degugj/lichessTesting/html/images/SPECS1.png

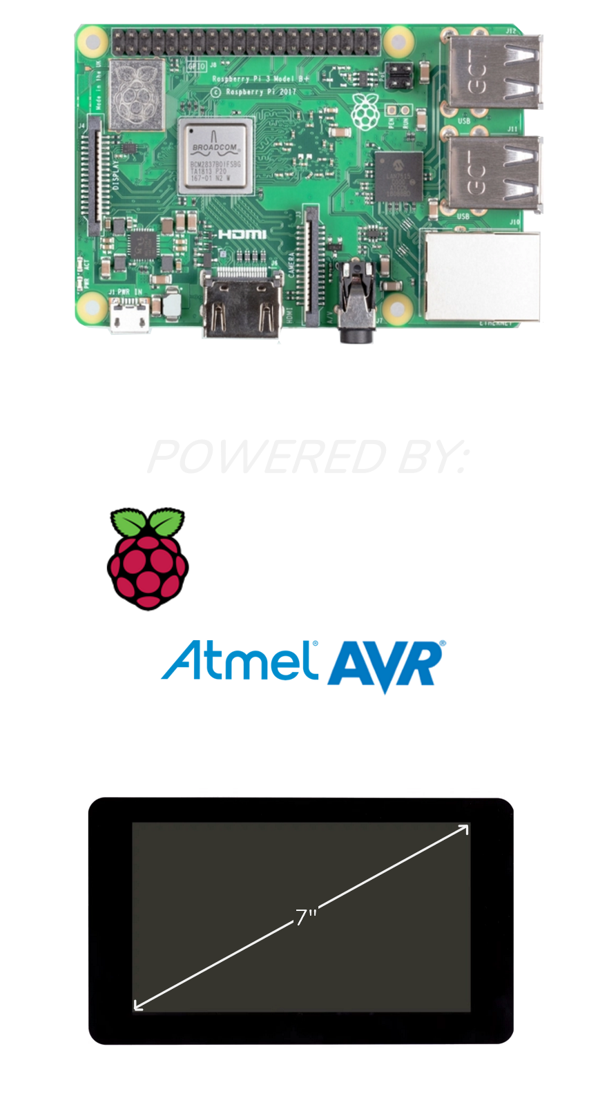
html/images/SPECS1.png
