degugj/lichessTesting/html/images/ZoomPortrait.png

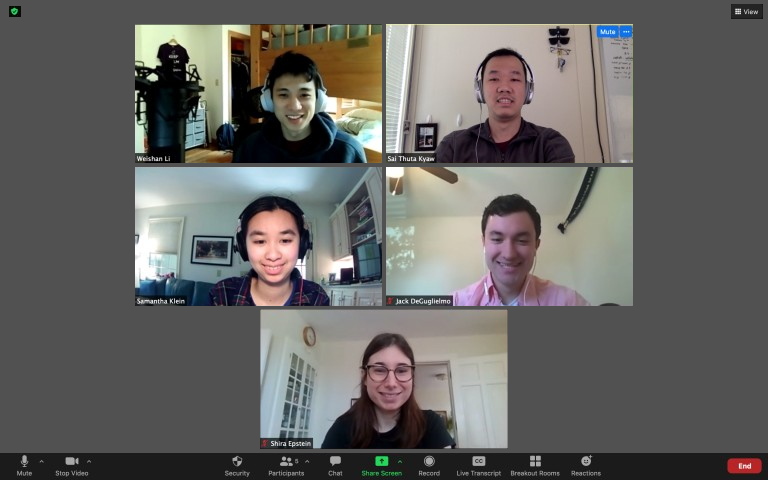
html/images/ZoomPortrait.png
