degugj/lichessTesting/readme.md

Magichess
============
Magichess is an autonomous, internet connected smart chessboard that interfaces with the the [lichess API](https://lichess.org/api).

**Contributors:**
  * Weishan Li CompE '21
  * Sai Thuta Kyaw EE '21
  * Samantha Klein EE '21
  * Jack DeGuglielmo CompE '21

University of Massachusetts Amherst '21
Electrical and Computer Engineering Senior Design Project
Team 10

## Dependencies

<!-- AUTO-GENERATED-CONTENT:START (DEPENDENCYTABLE) -->
| **Dependency** | **Description** | **Version** | **License** | **Type** |
| --- | --- | --- | --- | --- |
 | [pygame](https://github.com/pygame/pygame) | Open source software for illustrating game state. | 1.9.6 | GNU LGPL version 2.1 | N/A | 
 | [numpy](https://github.com/numpy/numpy) | N/A | N/A | N/A | N/A | 
 | [tkinter](https://github.com/python/cpython/tree/3.9/Lib/tkinter) | N/A | N/A | GPL | N/A | 
 | [Python](https://github.com/python/) | N/A | 3.8.8 | GPL | N/A | 
<!-- AUTO-GENERATED-CONTENT:END -->
