degugj/lichessTesting/html/pdf/T10 FPR.pdf

# MagiChess

## Jack DeGuglielmo, Samantha Klein, Weishan Li, Sai Thuta Kyaw

## Advisor: Shira Epstein

## Team 10

# Meet the team

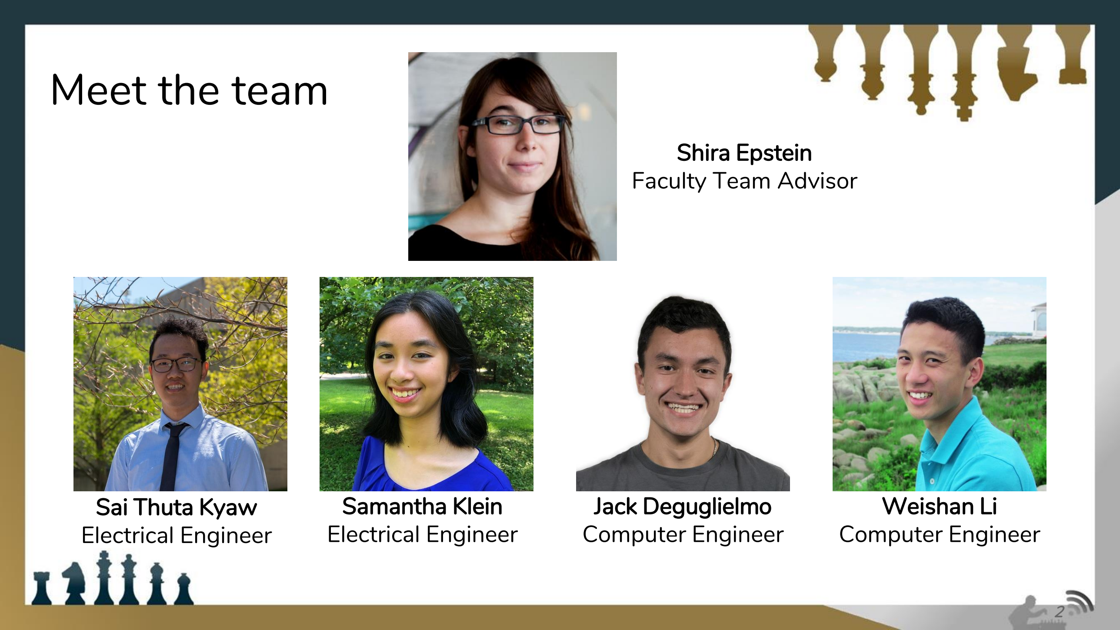
[picture p12: page 2]

Jack Deguglielmo
Computer Engineer

Samantha Klein
Electrical Engineer

Sai Thuta Kyaw
Electrical Engineer

Weishan Li
Computer Engineer

Shira Epstein
Faculty Team Advisor

# Problem Statement

For centuries, the game of chess has been played by two players sitting across a chessboard. The advent of digital technology in the last decades has brought virtual chess to computers and mobile phones and for the first time, this has allowed players to be anywhere across the world.

Digital chess lacks:
- A physical aspect/satisfaction of seeing and moving your own pieces Physical chess lacks:
- Ability to play from anywhere and with anyone

# Our Solution

We’ve decided to close the gap between physical and digital chess. To do this, we plan to create a chess board that allows users to play with an AI or a remote human opponent. Plan:
- Sense location of chess pieces on the board
- Interface with LiChess server
- Automate piece moving

# Preliminary System Specifications (Design-agnostic)

- Mechanically move a piece to destination cell
- Remove/replace a piece to/from game board
- Provide visual feedback
- Game setup, tutorial
- Game announcements
- Highlights previous move
- Provide audio feedback
- Notification alerts
- Play versus remote opponent
- Playback previous games
- Includes buffer zone to store captured pieces
- Topple the King after checkmate

# Preliminary System Specifications (Quantitative)

- Total system dimensions: no larger than 32.5 in x 30 in x 8in (80 cm x 74 cm x 15 cm )
- Speed of XY plotter: 5 - 8 cm/s
- Speed increased due to better stepper drivers
- Absolute maximum time taken for a move 25s
- Move each pieces under 10s more than half of the time
- Weight: Under 50lbs
- Upgrading from wood to more robust aluminium frame

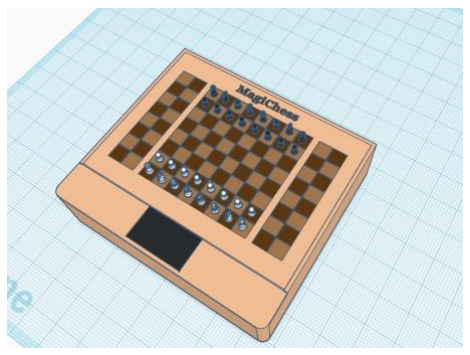
[picture p13: figure]

# Demo for Final System

- Tour the final assembly and hardware
- Comprehensive Gameplay Demo
- GUI Tour
- Functionalities to be covered:
■ | Capture (Movement and Sensor)
■ | Physical Gantry Movements
■ | Sensor Input Movements
- Game Replay Demo
- Previous Game Replay
- Topple King

# Documentation Overview

### - Communication Protocol Documents

- Fast Scanning Communication Protocol

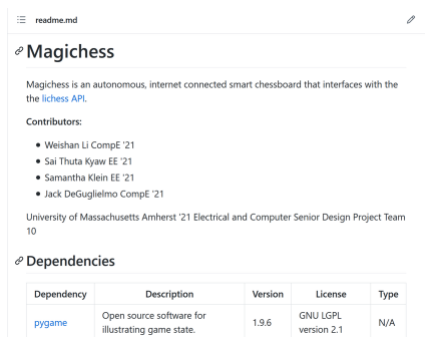
[picture p14: figure]
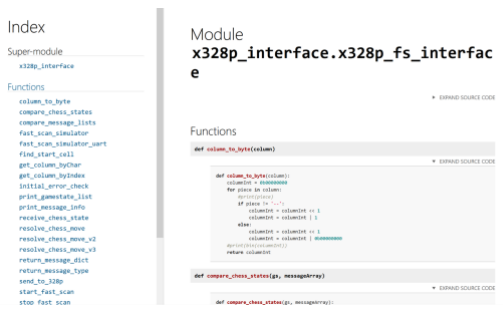
[picture p15: figure]

- XY Gantry Communication Protocol

### - System Software Documentation

- x328p_fs_interface.py (http://www.ecs.umass.edu/sdp/sdp21/team10/x328p_interface_docs/x328p_fs_interface.html) Document
- x328p_gantry_interface.py (http://www.ecs.umass.edu/sdp/sdp21/team10/x328p_interface_docs/x328p_gantry_interface.html) Document
- readme.md (https://github.com/degugj/lichessTesting/blob/master/readme.md) System Software Description

### - SDP Final Report

# Hardware + Software Flowchart

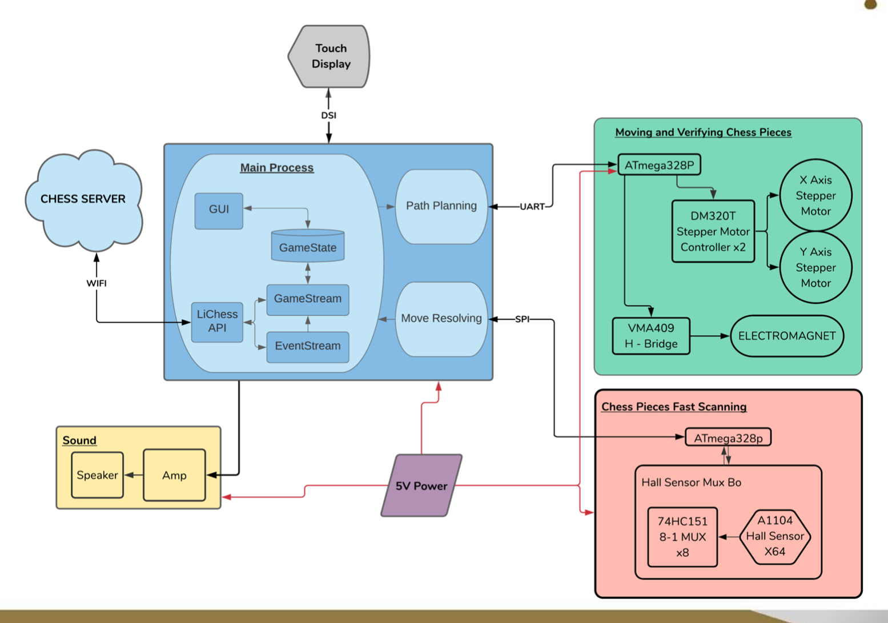
[picture p16: figure]

# Software Diagram - Game State

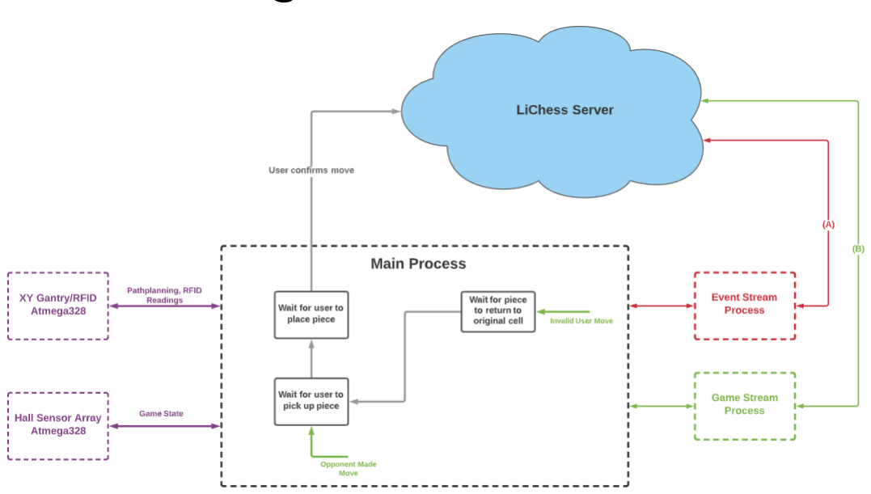
[picture p17: figure]

(A) gameStart,
challengeDeclined, …
(A) gameState, chatLine, ...

# Final System: GUI, Gamestate, Display

### - Graphical User Interface

- Interaction between chessboard, Lichess server, and user
- Housed on a Raspberry Pi touchscreen display
- Feedback provided through audio and various visual effects

### - Software Gamestate

- All moves (server-side and local-side) compare with and update our software gamestate
- Keeps track of physical pieces
- Stays aligned with server side gamestate
- Always on display to the user

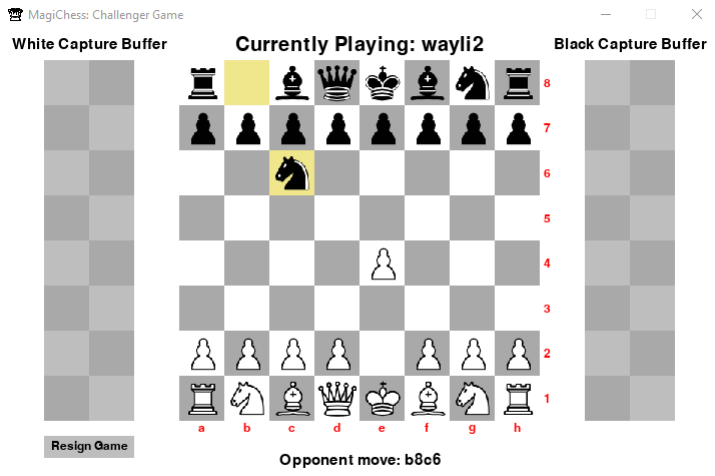
[picture p18: figure]

# Final System: Lichess Communication

### - Lichess

- Open source chess server with very well documented API
- Request and response communication

### - Gamestream and Eventstream

- Separate processes running simultaneously with main application
- Constantly request data from Lichess
- Place responses in respective queues and grab from main process

# Final System: Path Planning

### Path Planning Sequence

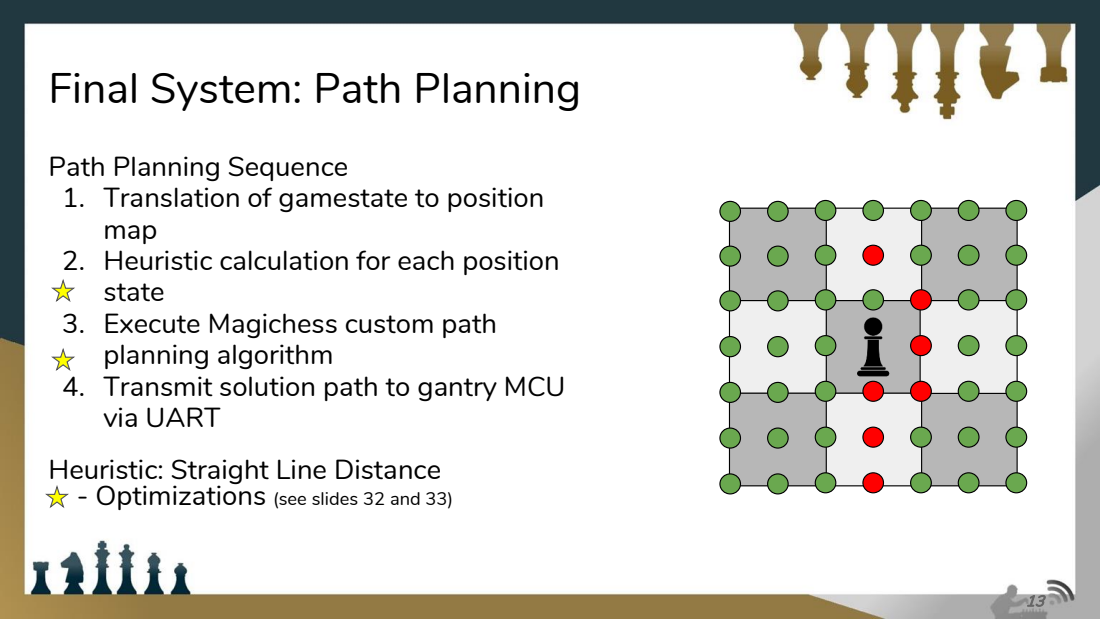
[picture p19: page 13]

1. Translation of gamestate to position
map
2. Heuristic calculation for each position
state
3. Execute Magichess custom path
planning algorithm
4. Transmit solution path to gantry MCU
via UART
Heuristic: Straight Line Distance - Optimizations (see slides 32 and 33)

# Final System: Gantry

- UART data sent from Path Planning
- 9600 baud, 8 bits, no parity
- 3 bit type + 5 bit data
- See Documentation for more details
- DM320T Stepper Motor Drivers
- Rising Edge Activation + Direction Control
- LM320T based H-Bridge
- Electromagnet control
- ATmega328p
- Processes UART commands
- Calculates coordinates for the next position point

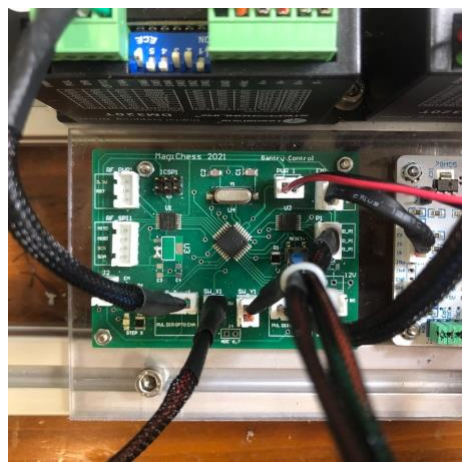
[picture p20: figure]

# Final System: Fast Scanning

- SPI mode 0
- ATmega328p configured as Slave
- See SPI Communication Detail for more information
- 328p waits for prompt from Pi to send data for a specific column (a-h)
- Pi sends a request for scanning each column
- 328 responds with data from corresponding column

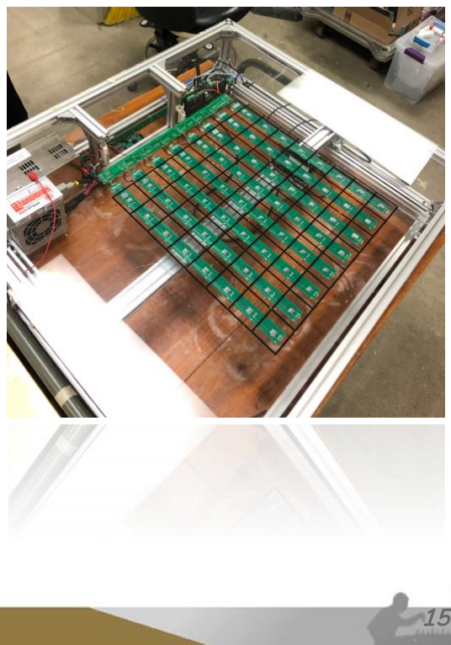
[picture p21: figure]
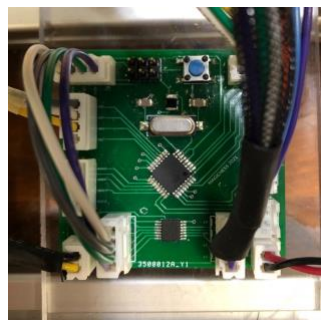
[picture p22: figure]

# Final System: Move Resolution

Fast Scanning MCU

Raspberry Pi

Initial Chess
State

Previous
Chess State

Resolved Physical User Move
(see slides 34-36 for examples)

New Physical Game
State

# Final system Overview:

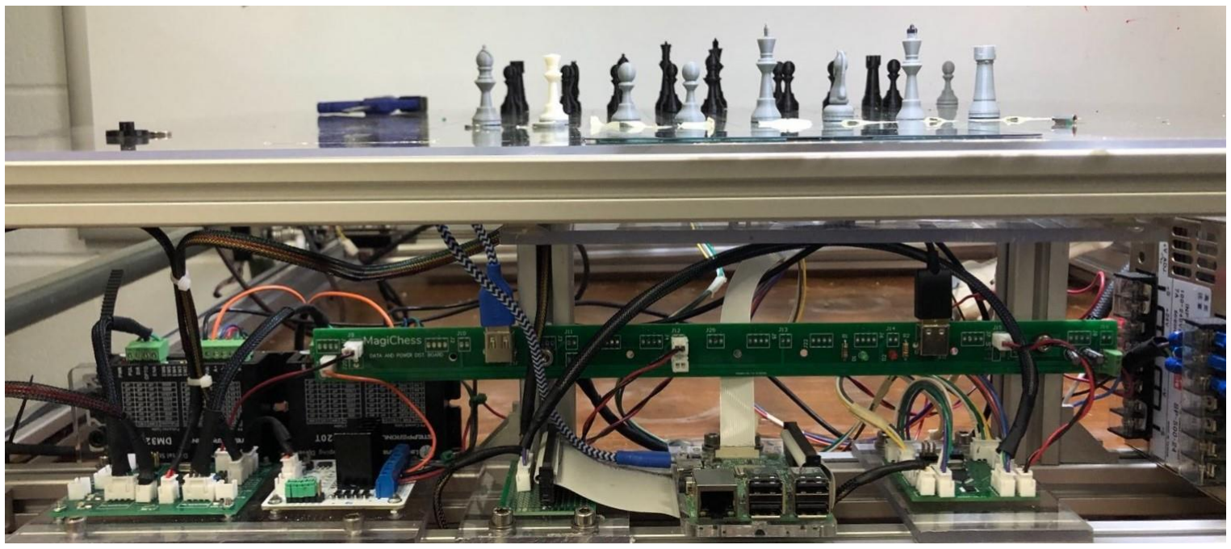
[picture p23: figure]

# Integrated PCB Close Up

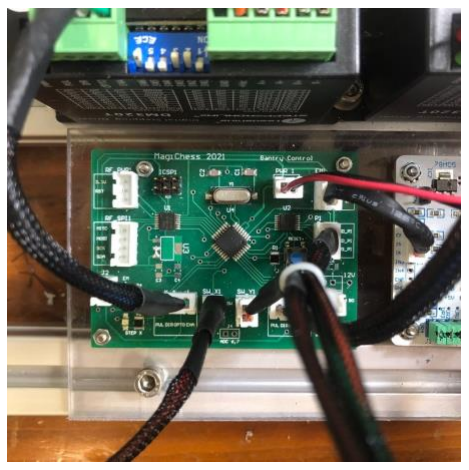
[picture p24: figure]
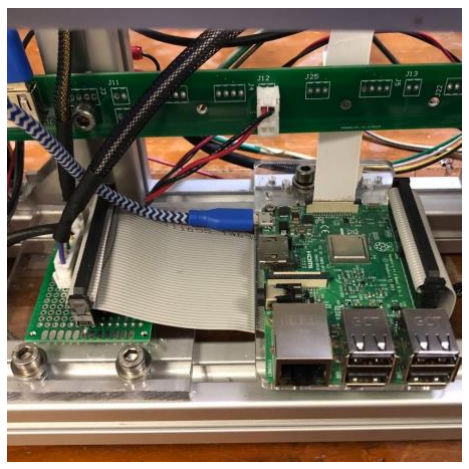
[picture p25: figure]
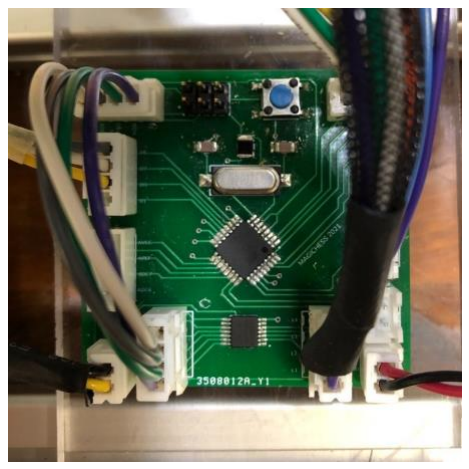
[picture p26: figure]

# FPR Accomplishments

### - Fast Scanning

- Resolve consecutive moves
- Resolve capturing, castling, etc.
- Full integration with gantry system

### - Movement

- Optimized for the final system
- Self-Calibrate and communication with Pi

### - GUI

- Integrated with different subsystems
- Visual and audio feedback

# FPR Accomplishments

- Mechanically move a piece to destination cell
- Remove/replace a piece to/from game board
- Provide visual feedback
- Game announcements
- Highlights previous move
Audio feedback
Notification alerts
- Play versus remote opponent
- Playback previous games
- Includes buffer zone to store captured pieces
- Topple the King after checkmate

# Total Spending

Total Spending (Fall Semester) | 264.83
Stepper Motor Drivers | 40.1
Prototype (DigiKey) | 29.49
JLC PCB | 49.36
PCB Population (DigiKey) | 57.19
PCB Population (Newark) | 41.84
Budget Extension | +150
Post-CDR | 112.19
Total Spent | 595
Remaining Budget | 55

# Fun Facts!

## - 380+ Commits on GitHub - 3.75 hrs/week of group + advisor meetings

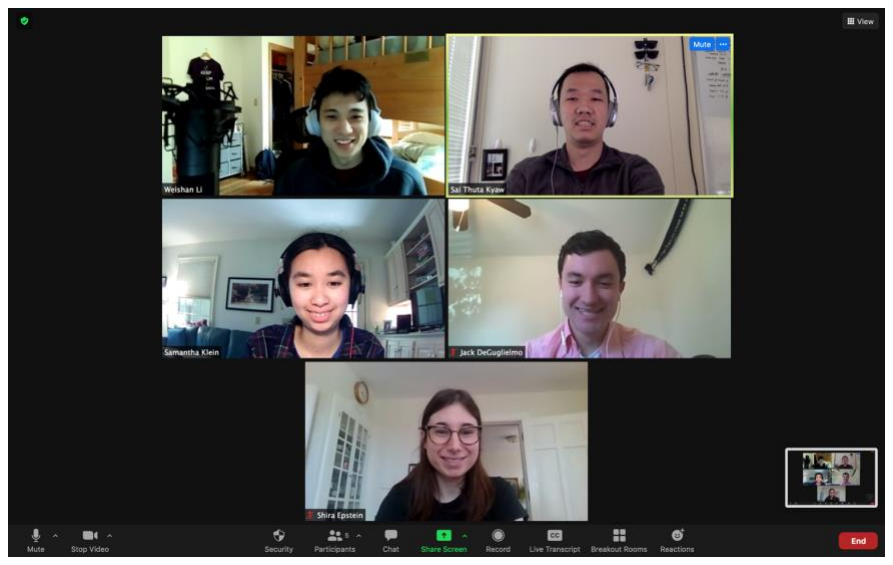
[picture p27: figure]

# External Links

### Team Website (http://www.ecs.umass.edu/sdp/sdp21/team10/index.html)

All Demo Videos Playlist (https://www.youtube.com/playlist?list=PLN2cGbKly2ZLBdtQRyGbDLnbU6EHeFFv1)

### Github Repo (https://github.com/degugj/lichessTesting)

Next Steps...

### - Functionalities for SDP Demo Day

- Sensing Physical User Edge Case Moves (castling, en passant)
- Autonomous Board Reset
- Resume Ongoing Games

### - Future Direction and Works

- RFID for piece identification or removal of PCB copper plane (see slide )
- Sensing Physical User’s Promotion
- Tutorial/Video on how to play and use the Magichess system

# Thank You
