degugj/lichessTesting/html/images/chess128.png

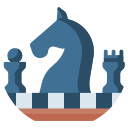
html/images/chess128.png
