degugj/lichessTesting/html/images/Chess Exploded.png

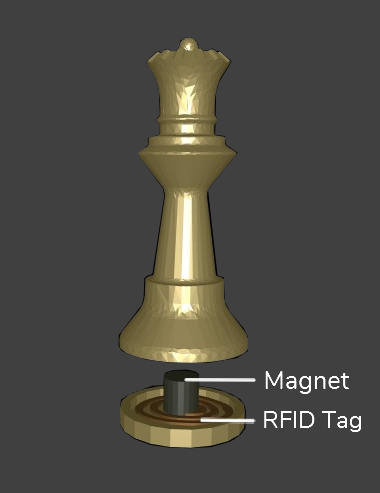
html/images/Chess Exploded.png
