degugj/lichessTesting/html/images/Dimensions.png

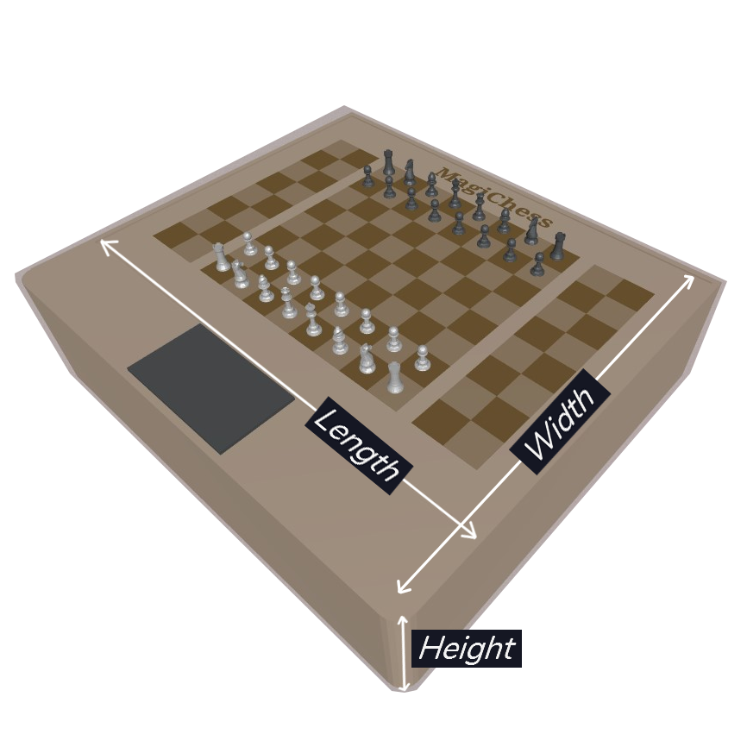
html/images/Dimensions.png
