degugj/lichessTesting/html/images/Exploded Chess.jpg

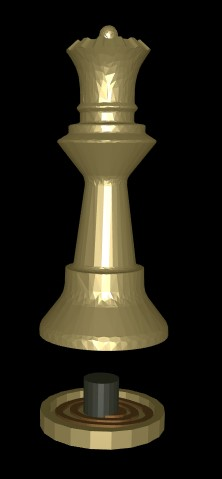
html/images/Exploded Chess.jpg
