degugj/lichessTesting/html/images/FSPCB.jpg

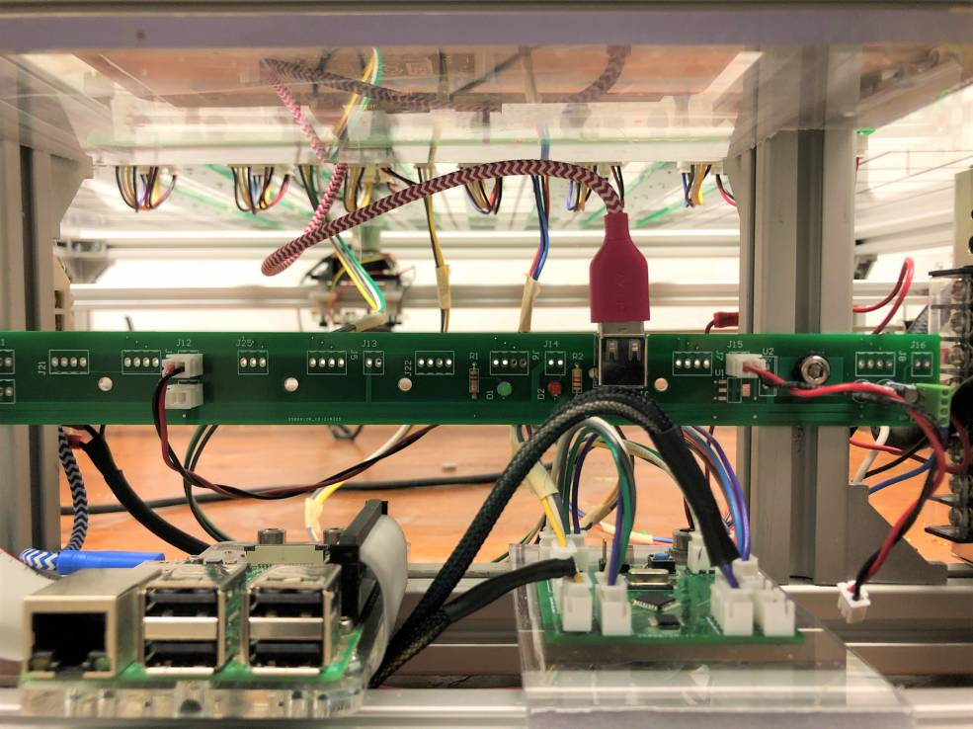
html/images/FSPCB.jpg
