degugj/lichessTesting/html/images/gantry.jpg

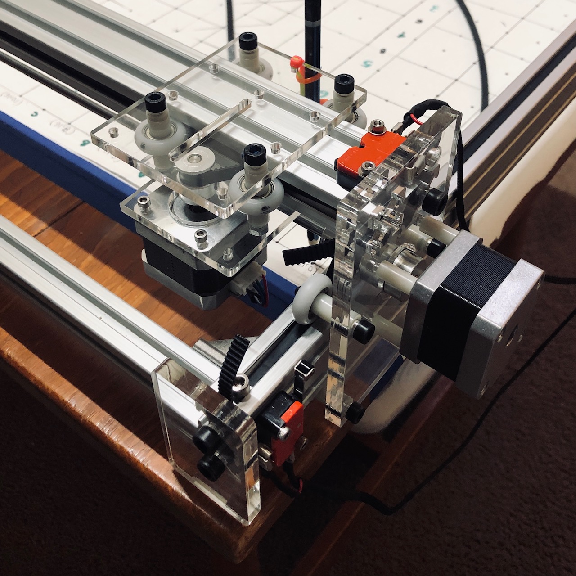
html/images/gantry.jpg
