degugj/lichessTesting/html/images/GantryPCB.jpg

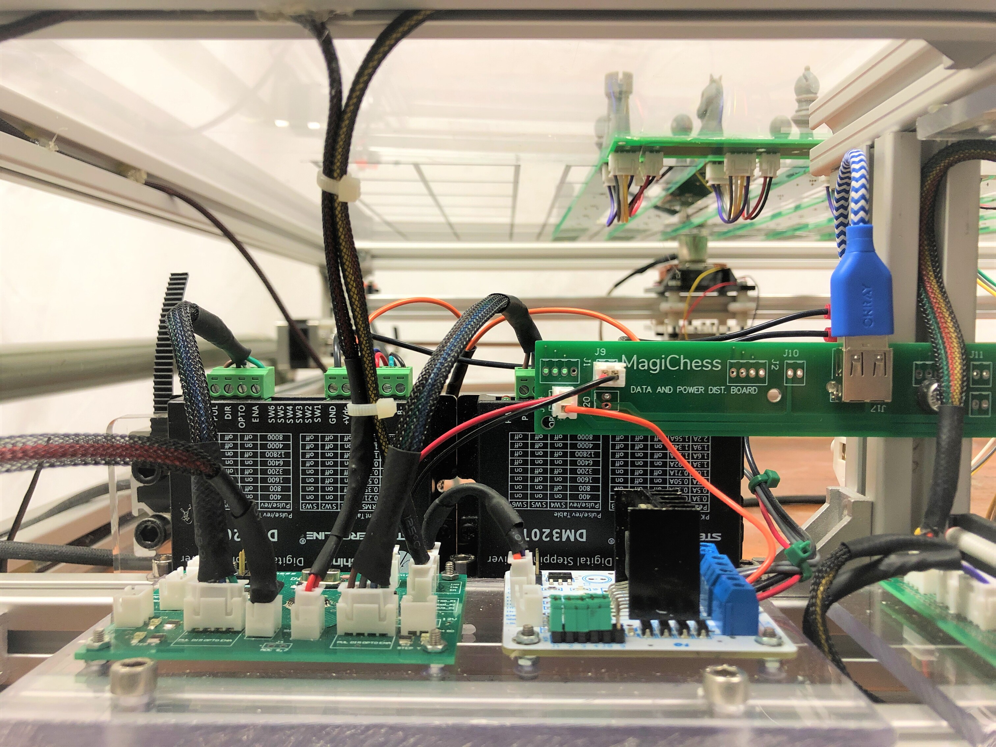
html/images/GantryPCB.jpg
