degugj/lichessTesting/html/images/GitCommits.png

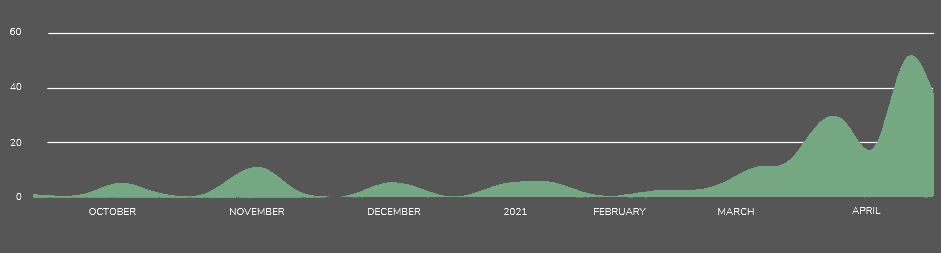
html/images/GitCommits.png
