degugj/lichessTesting/html/images/HW Flow.png

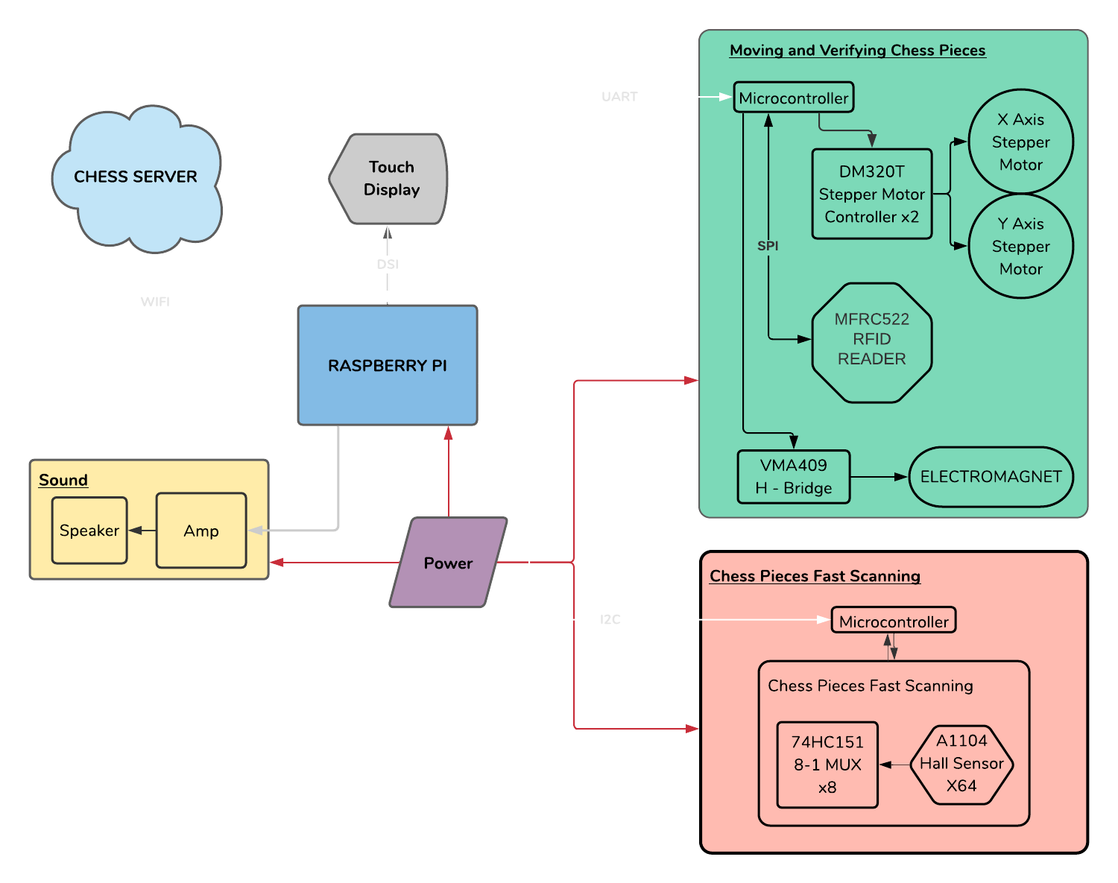
html/images/HW Flow.png
