degugj/lichessTesting/html/images/IMG_1572.jpg

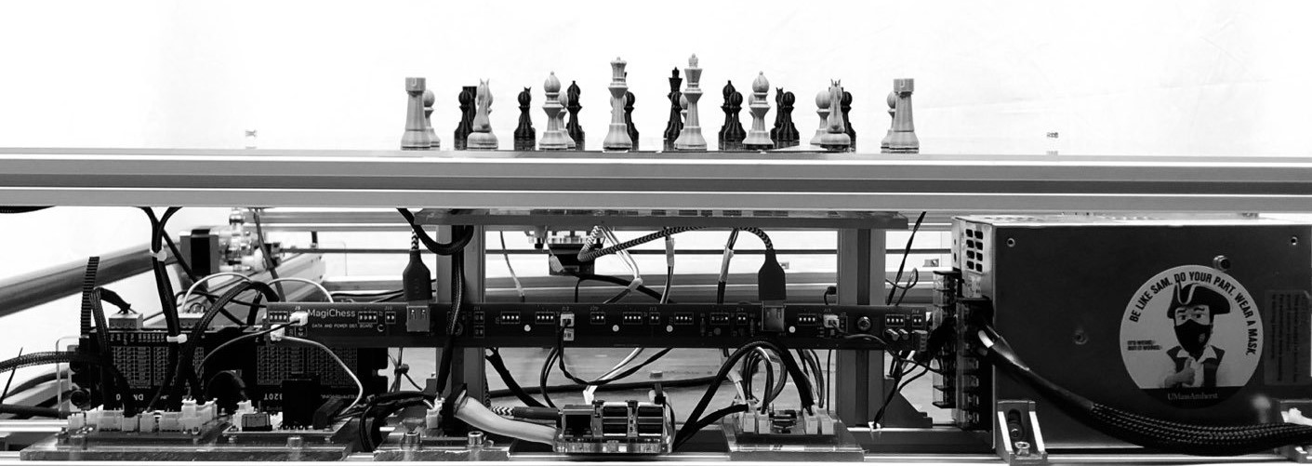
html/images/IMG_1572.jpg
