degugj/lichessTesting/html/images/Jack.jpg

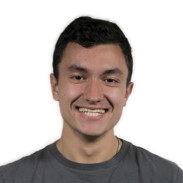
html/images/Jack.jpg
