degugj/lichessTesting/html/images/pathplanning.jpg

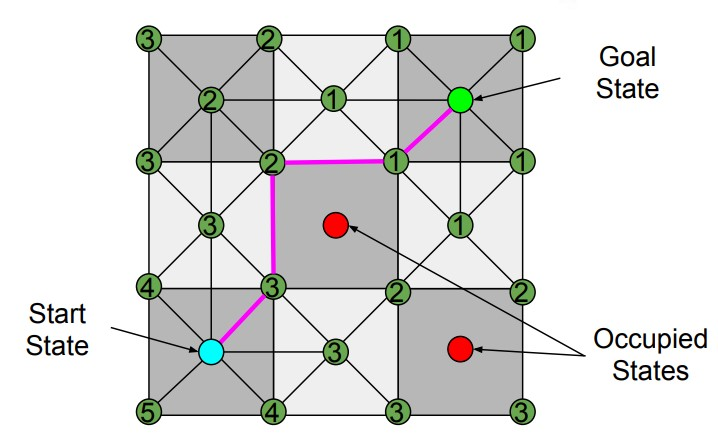
html/images/pathplanning.jpg
