degugj/lichessTesting/html/images/Sai.jpg

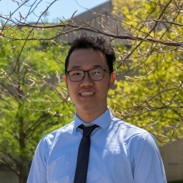
html/images/Sai.jpg
