degugj/lichessTesting/html/images/Sam.jpg

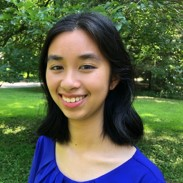
html/images/Sam.jpg
