degugj/lichessTesting/html/images/sensor.jpg

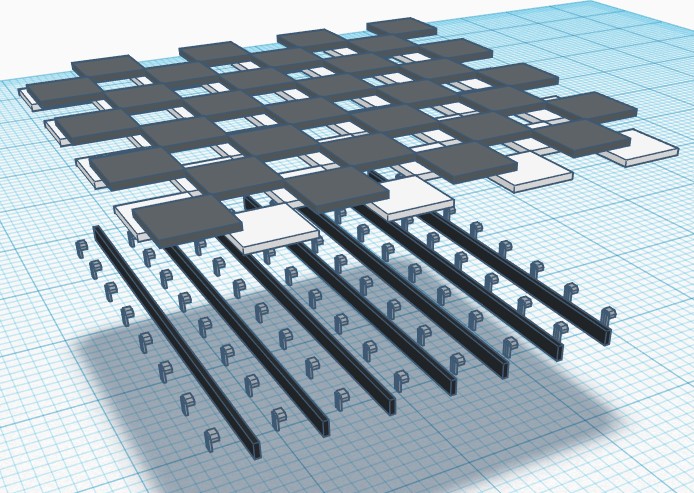
html/images/sensor.jpg
