degugj/lichessTesting/html/images/Shira.jpg

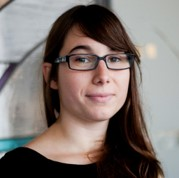
html/images/Shira.jpg
