degugj/lichessTesting/html/images/SW Flow.png

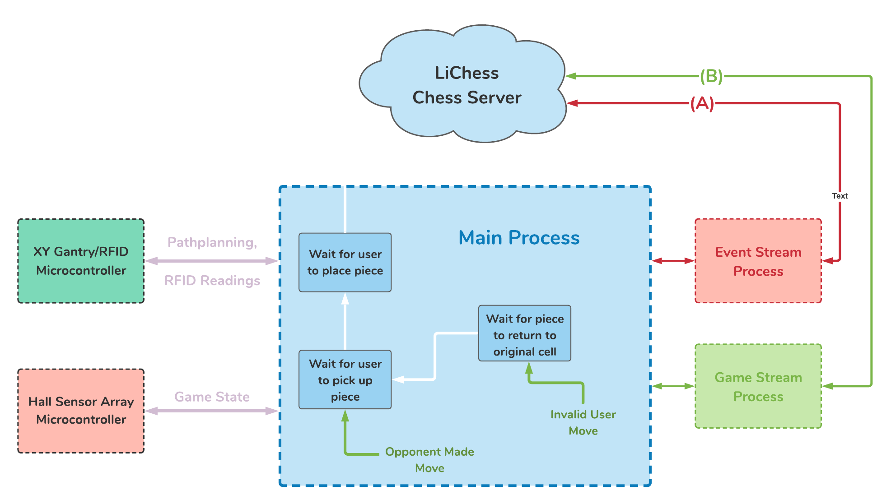
html/images/SW Flow.png
