degugj/lichessTesting/html/images/system.png

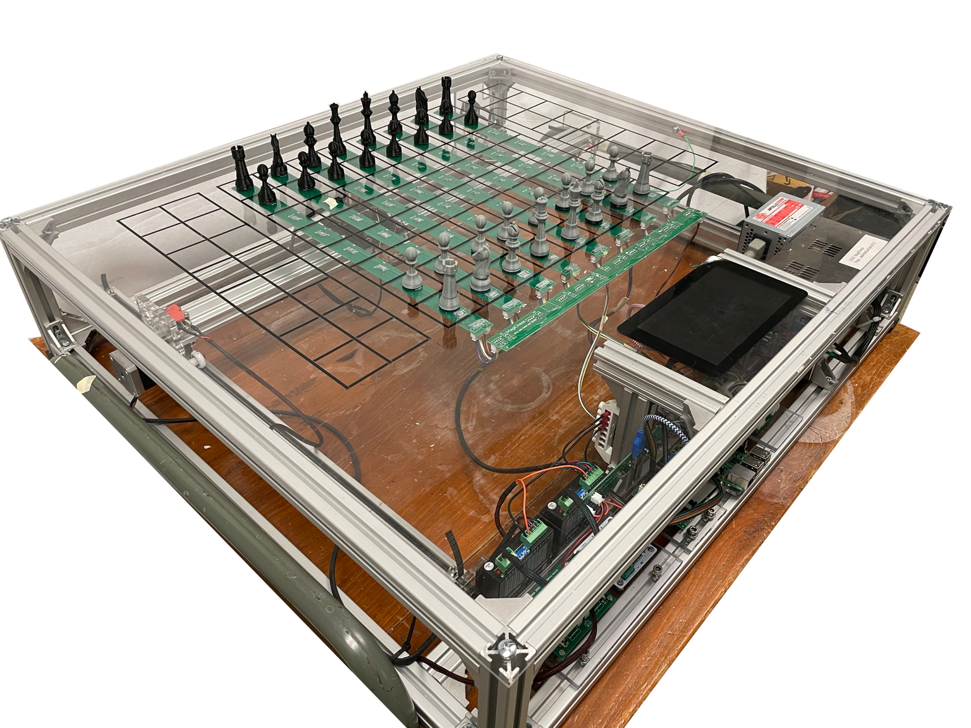
html/images/system.png
