degugj/lichessTesting/html/images/Wei.jpg

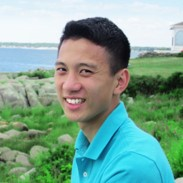
html/images/Wei.jpg
