degugj/lichessTesting/html/pdf/xGantryBOM.pdf

# CONSTRUCTION DOCUMENTATION

## Design Title : GantryFrame

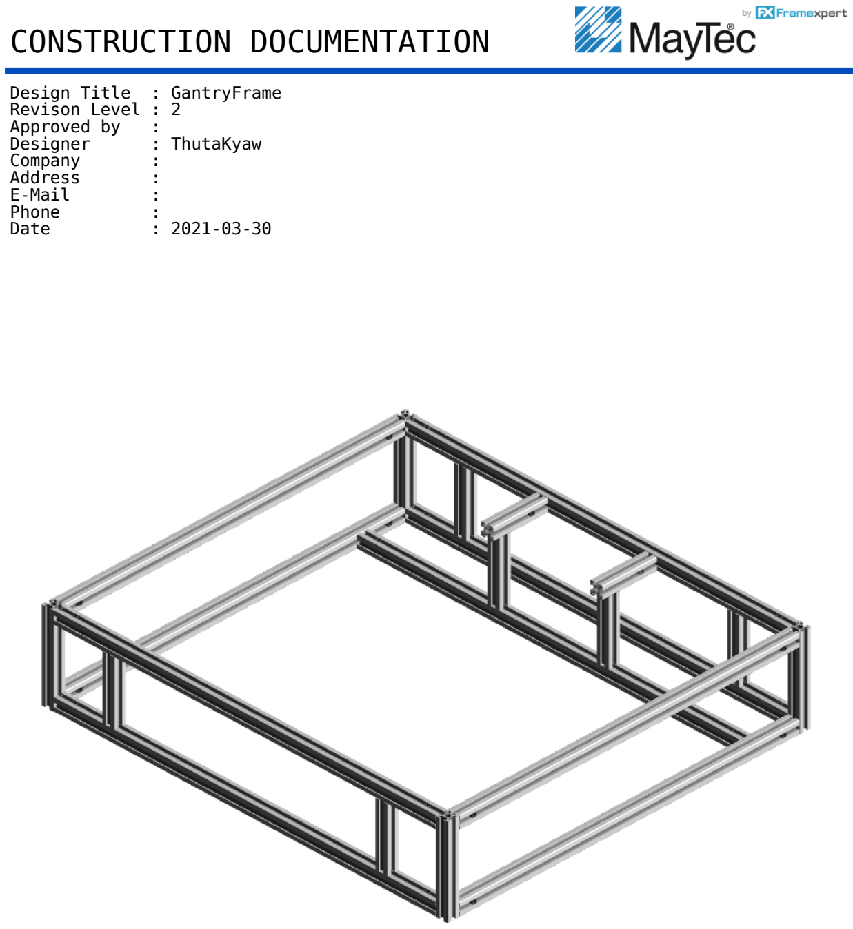
[picture p54: page 1]

## Revison Level : 2

Approved by | :
Designer | : ThutaKyaw
Company | :
Address | :
E-Mail | :
Phone | :
Date | : 2021-03-30

Pos | Article-No | Description | Units | Qty | Each $ | Price $
1 | 2.11.010010.43SP-AA4A00/4.500 | Profile 1"x1", 4F, plain | IN | 2 | 5.48 | 10.96
2 | 2.11.010010.43SP-A00A00/7.000 | Profile 1"x1", 4F, plain | IN | 4 | 4.30 | 17.21
3 | 2.11.010010.43SP-AA4AA4/28.000 | Profile 1"x1", 4F, plain | IN | 4 | 15.21 | 60.83
4 | 2.11.010010.43SP-AA4AA4/31.500 | Profile 1"x1", 4F, plain | IN | 5 | 16.36 | 81.79
5 | 2.11.010010.43SP-AA4AA4/5.000 | Profile 1"x1", 4F, plain | IN | 6 | 7.64 | 45.87
6 | 2.21.10F0 | Connector, universal | EA | 32 | 3.37 | 107.84
Total Weight: | 7.48 kg (16.49 lbs) | Total (USD): | $ 324.50
* The price indicated above, does not include assembly, packaging, taxes and transport.
Version : 7.250 | Page 2
Design Title | : GantryFrame
Customer Name | : ThutaKyaw
Date | : 2021-03-30

## Construction documentation

# Bill of materials (Number of kits: 1)

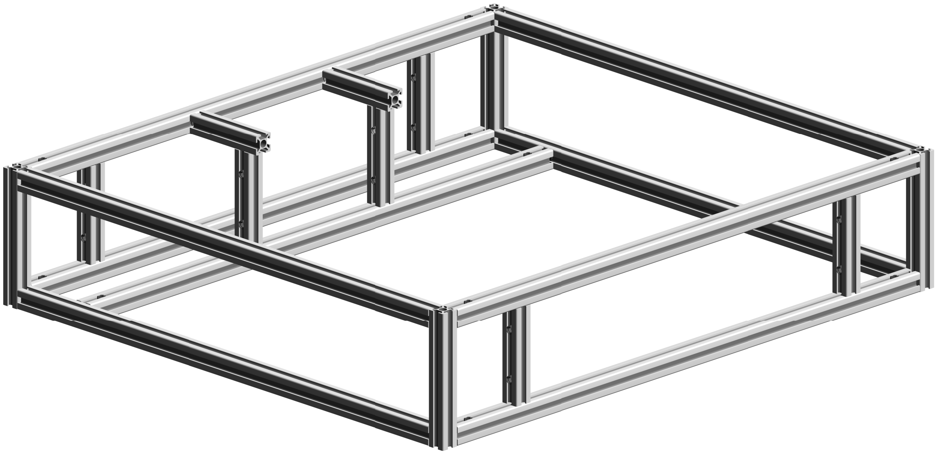
[picture p55: figure]

Version : 7.250 | Page 3

# Isometric view

### Some accessories may not be shown

# Multiview

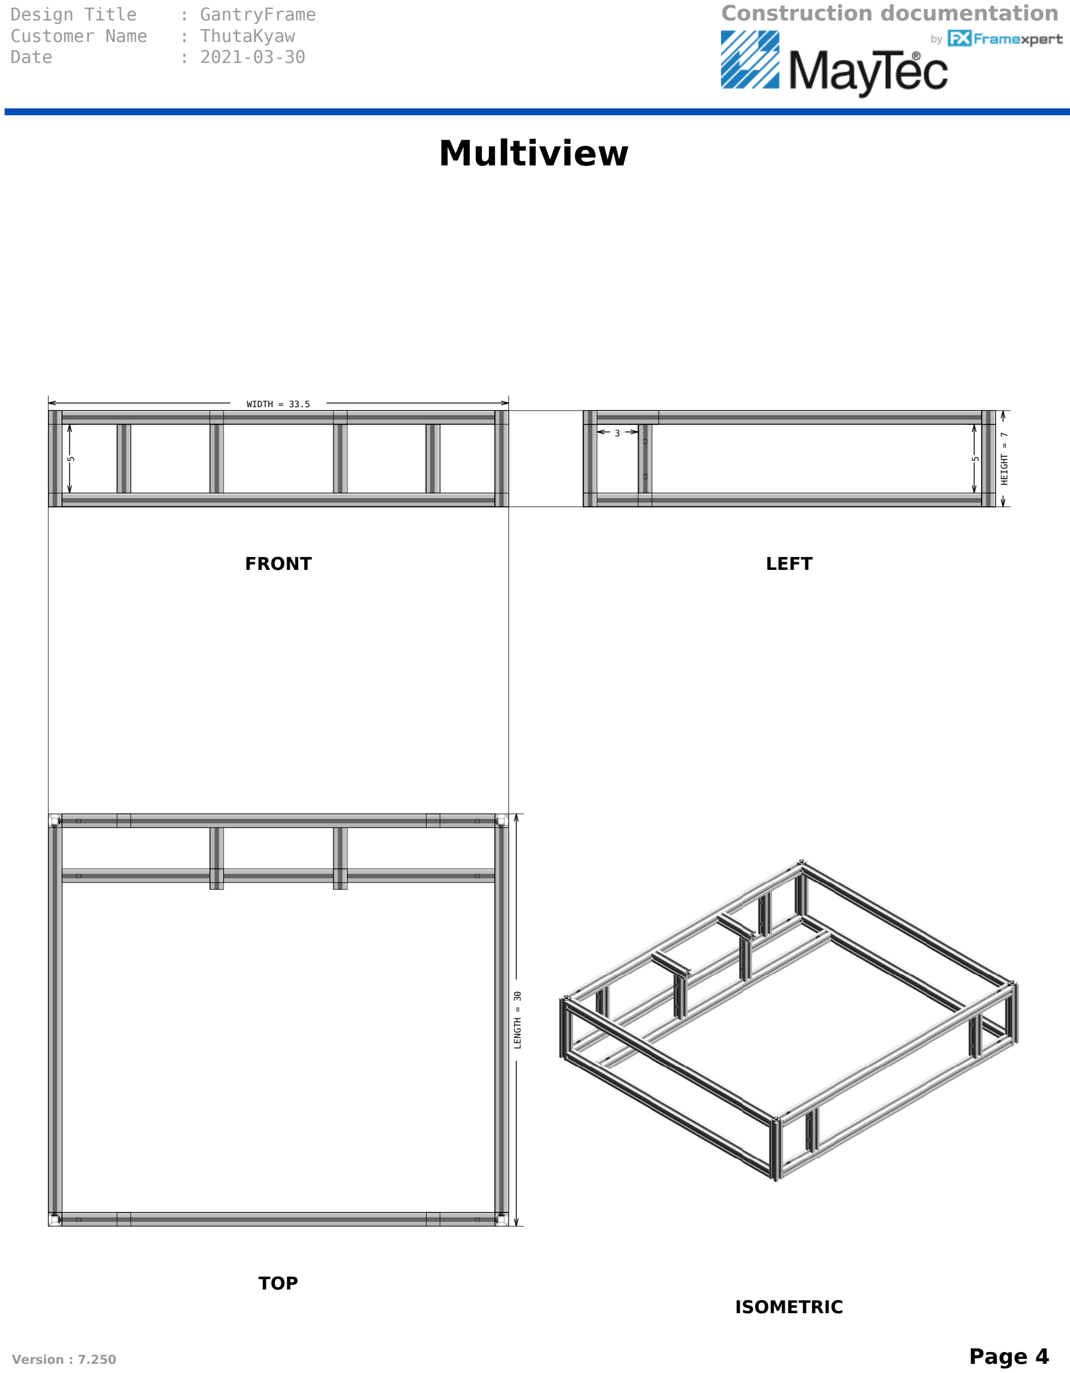
[picture p56: page 4]

5

WIDTH = 33.5

### FRONT

3

5

HEIGHT = 7

### LEFT

LENGTH = 30

### TOP ISOMETRIC

Version : 7.250 | Page 4

# FRONT VIEW

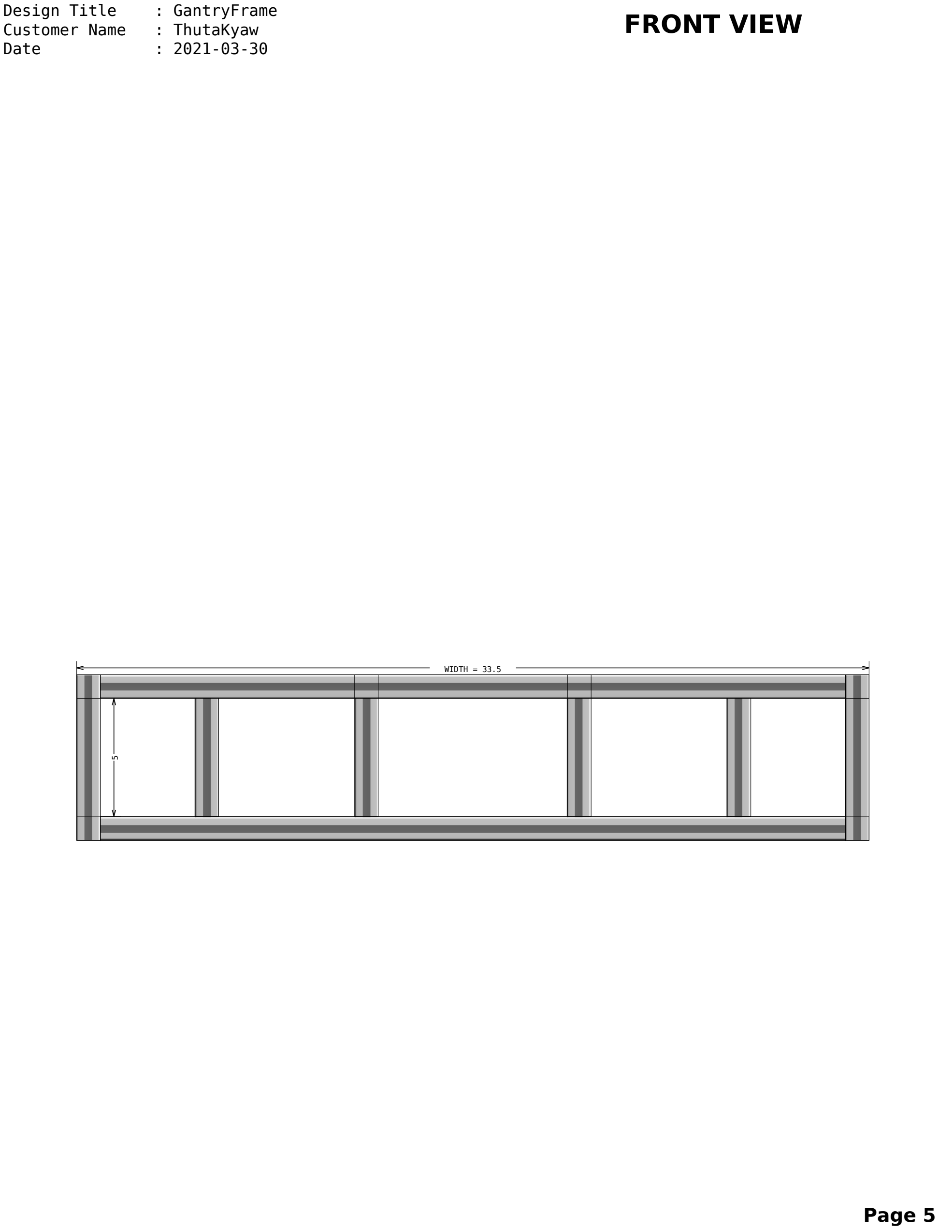
[picture p57: page 5]

5

WIDTH = 33.5

## Page 5

# LEFT VIEW

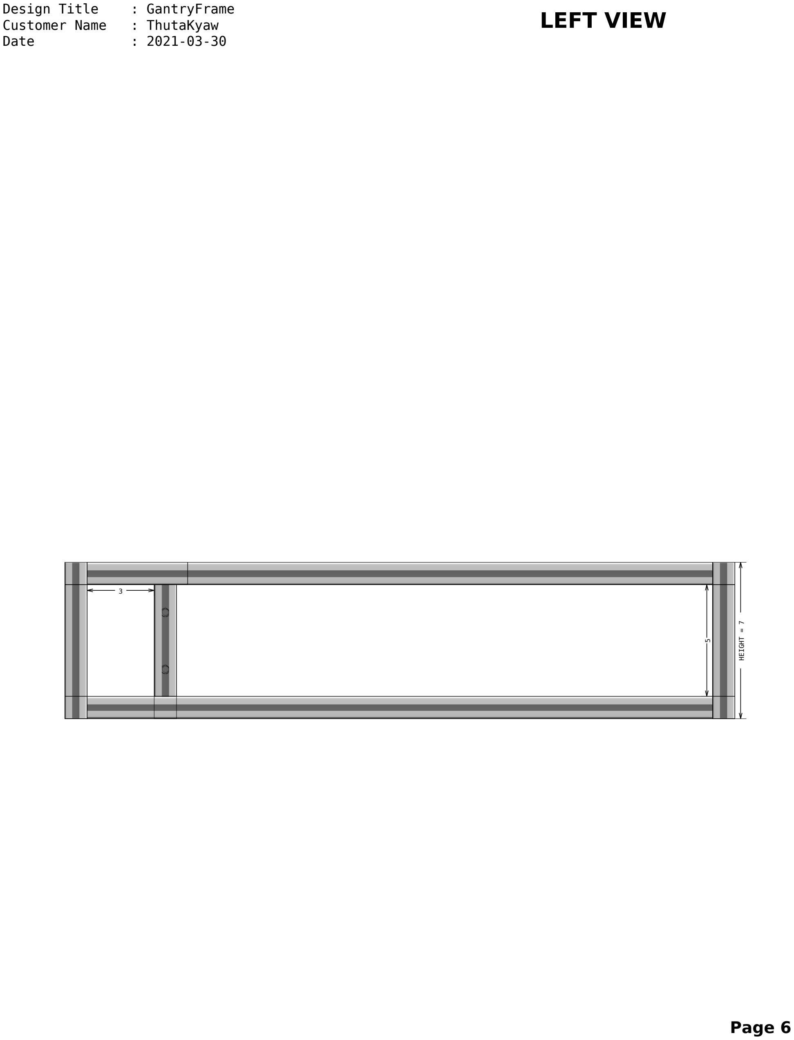
[picture p58: page 6]

3

5

HEIGHT = 7

## Page 6

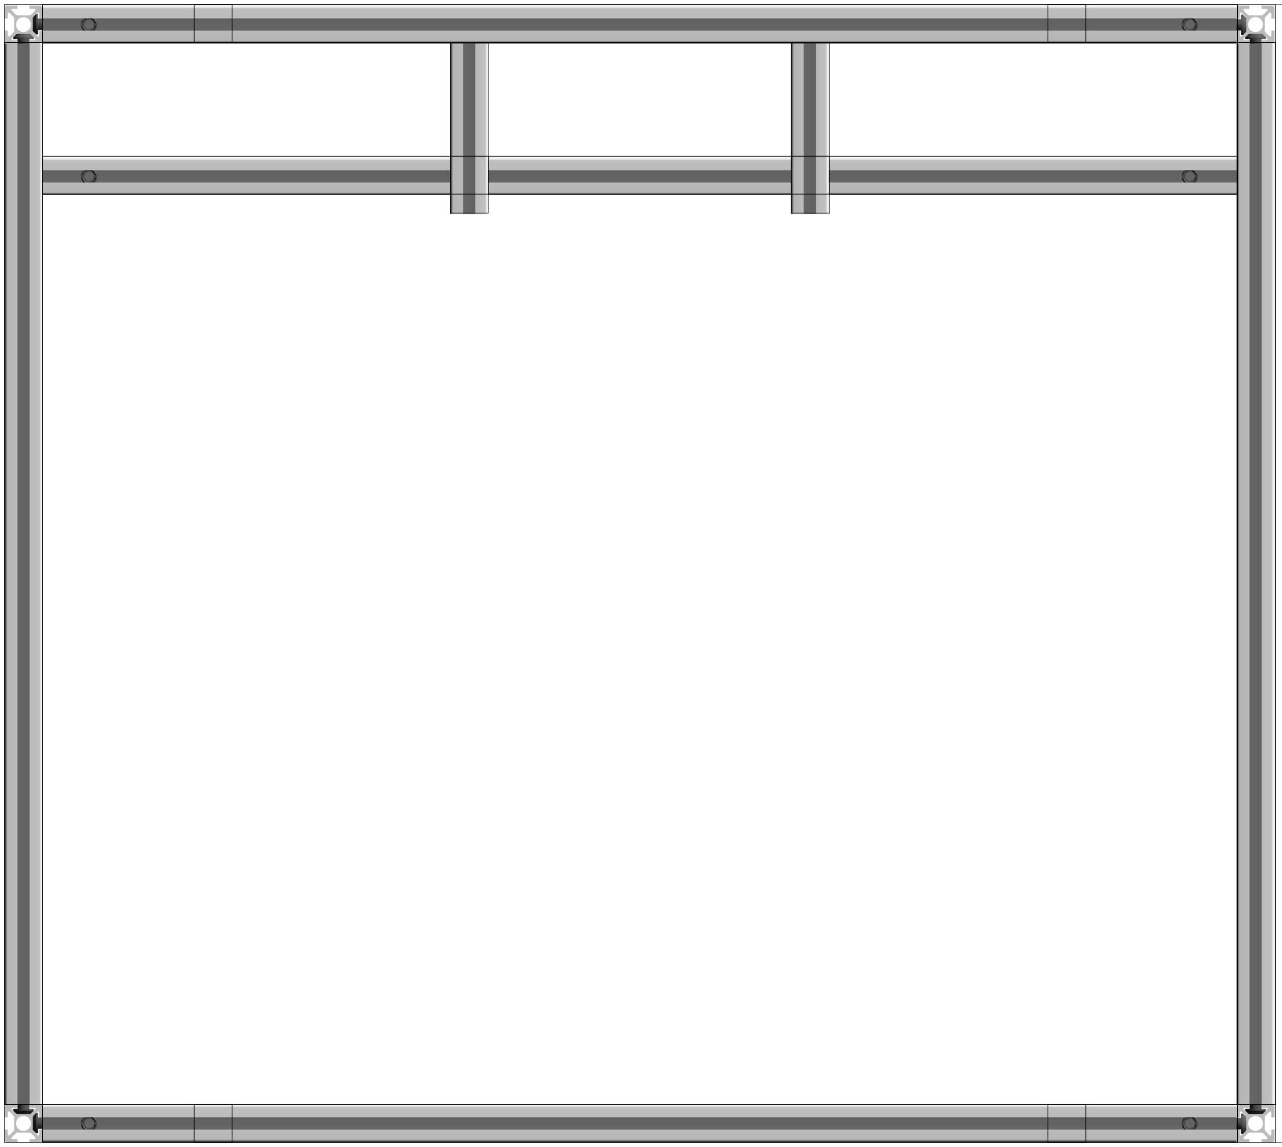
[picture p59: figure]

LENGTH = 30

## Page 7

# TOP VIEW

# Exploded view

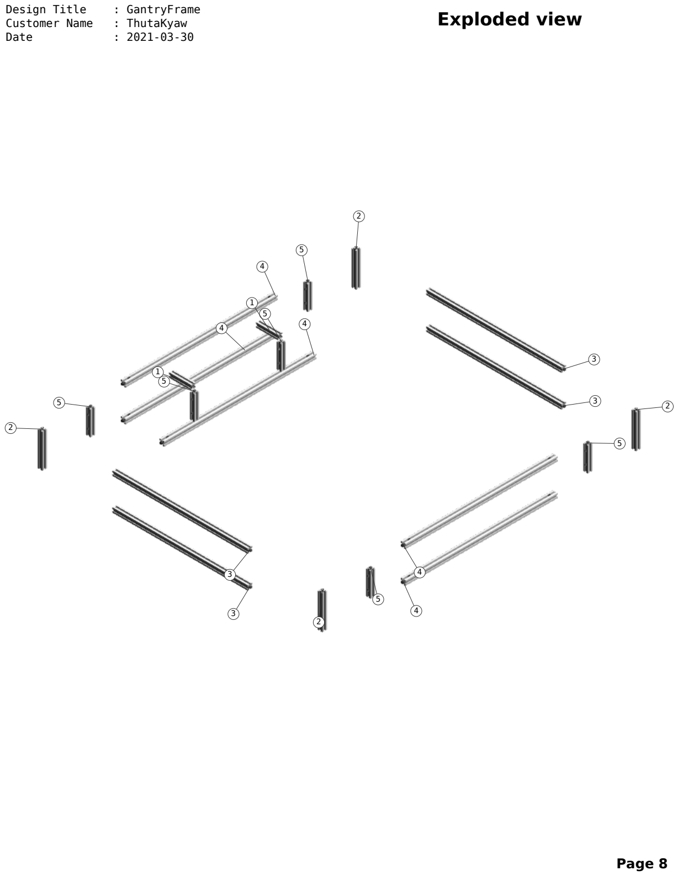
[picture p60: page 8]

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
## Page 8

Article-No | Cuts | Waste (")

2.11.010010.43SP

7.000
7.000

7.000
28.000

28.000
31.500

31.500
31.500

31.500
31.500
2 | 2 | 2 | 3 | 3 | 4 | 4 | 4 | 4 | 4

0.343"

4.500
4.500

5.000
5.000

5.000
5.000

5.000
5.000

7.000
28.000

28.000

1 | 1 | 5 | 5 | 5 | 5 | 5 | 5 | 2 | 3 | 3

132.705"

Version : 7.250 | Page 9

# Suggested profile cuts (incl. kerf: 3.5 mm)
