degugj/lichessTesting/html/pdf/T10 PDR.pdf

## Team 10

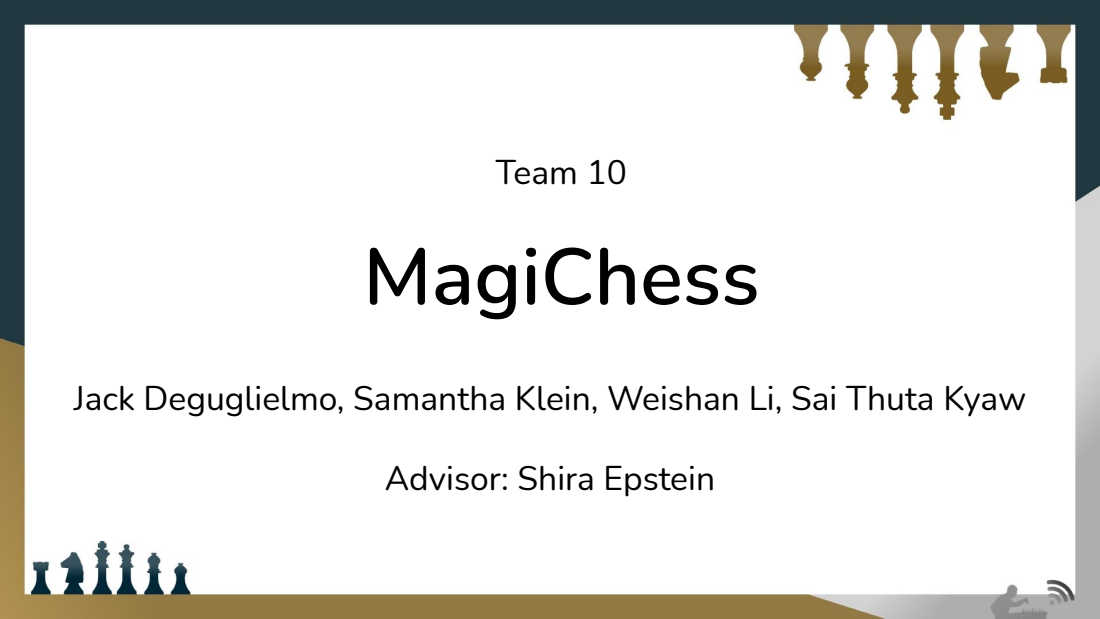
[picture p61: page 1]

Jack Deguglielmo, Samantha Klein, Weishan Li, Sai Thuta Kyaw

Advisor: Shira Epstein

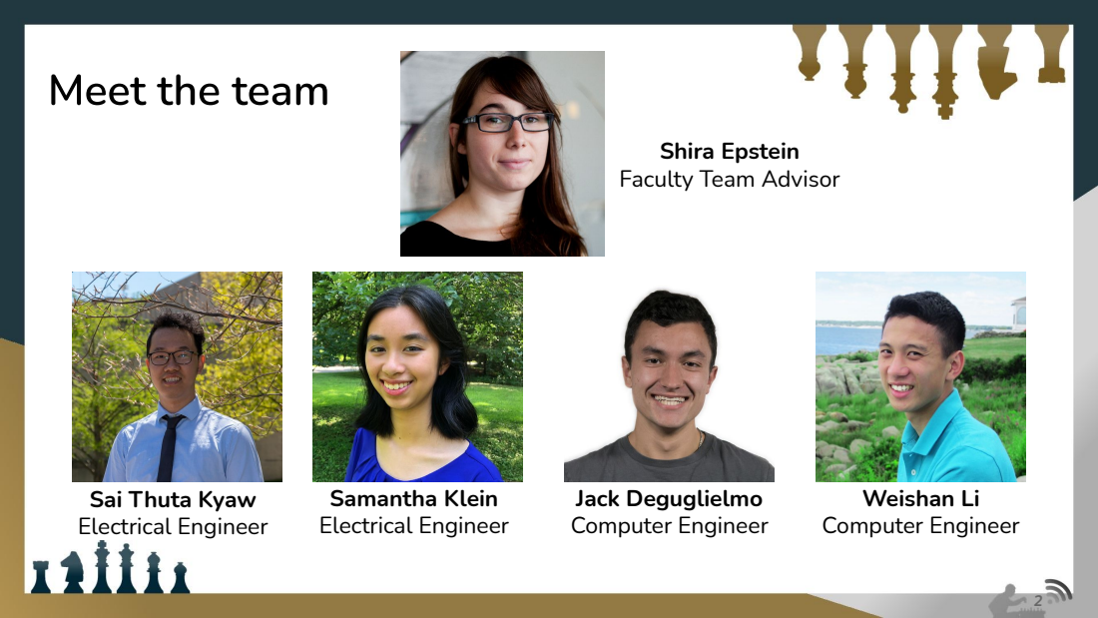
[picture p62: page 2]
Jack Deguglielmo Computer Engineer; Samantha Klein Electrical Engineer; Weishan Li Computer Engineer

Shira Epstein
Faculty Team Advisor

Sai Thuta Kyaw
Electrical Engineer

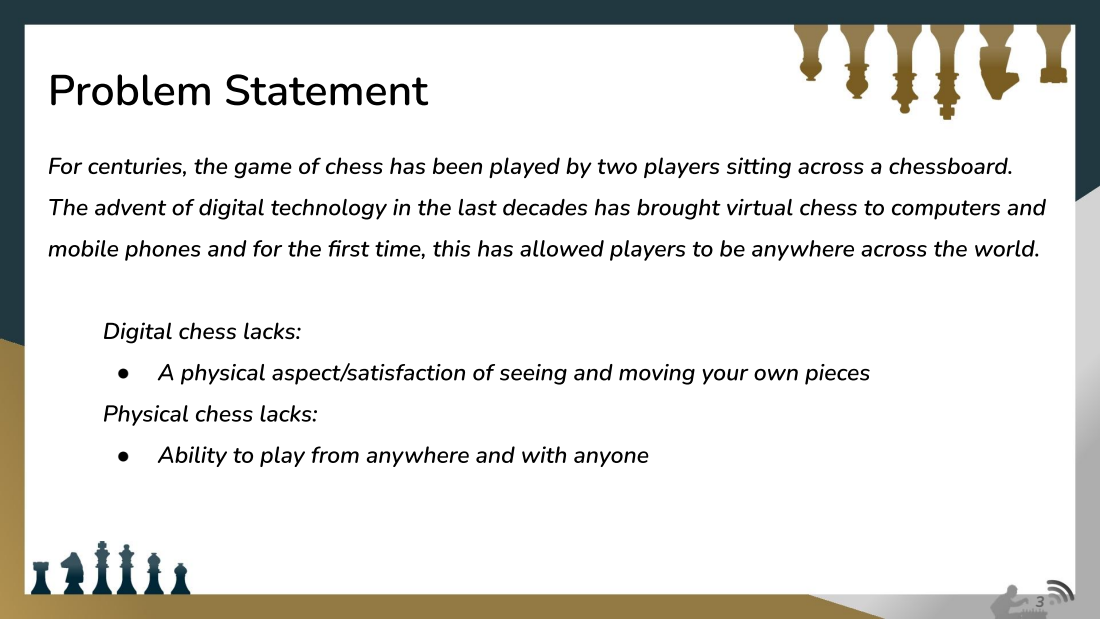
[picture p63: page 3]

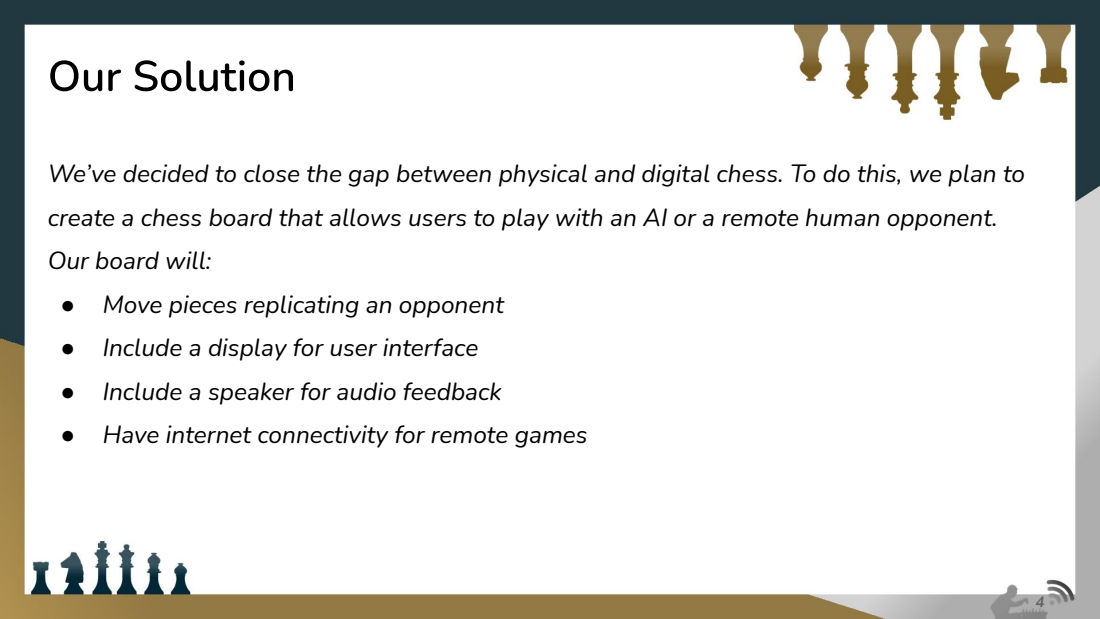
[picture p64: page 4]

We’ve decided to close the gap between physical and digital chess. To do this, we plan to
create a chess board that allows users to play with an AI or a remote human opponent.
Our board will:
● Move pieces replicating an opponent
● Include a display for user interface
● Include a speaker for audio feedback
● Have internet connectivity for remote games

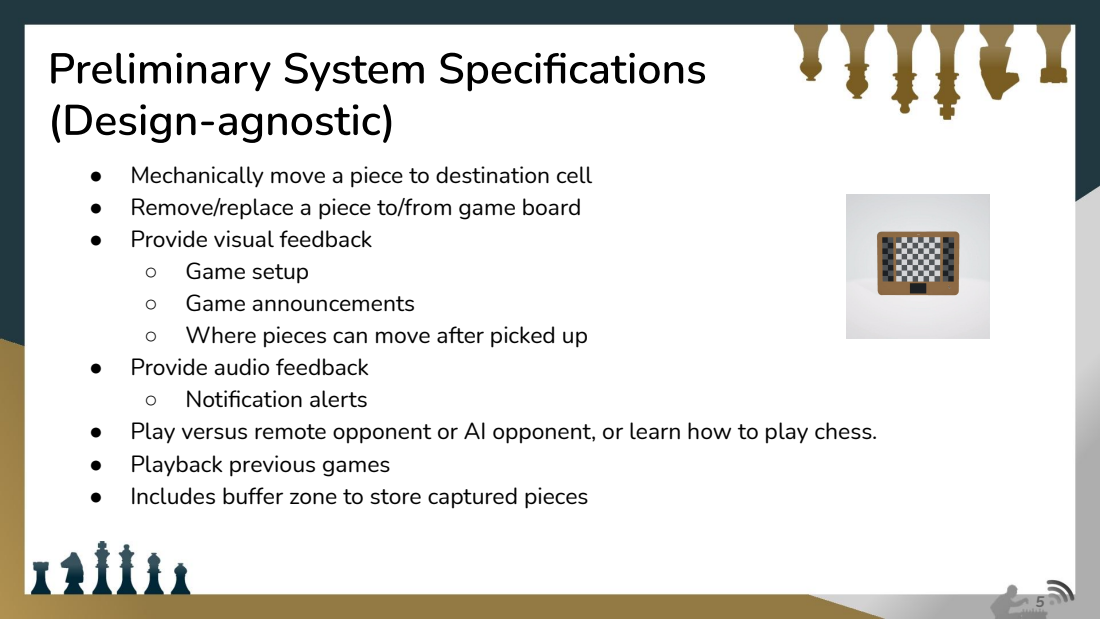
[picture p65: page 5]

● Mechanically move a piece to destination cell
● Remove/replace a piece to/from game board
● Provide visual feedback
○ Game setup
○ Game announcements
○ Where pieces can move after picked up
● Provide audio feedback
○ Notification alerts
● Play versus remote opponent or AI opponent, or learn how to play chess.
● Playback previous games
● Includes buffer zone to store captured pieces

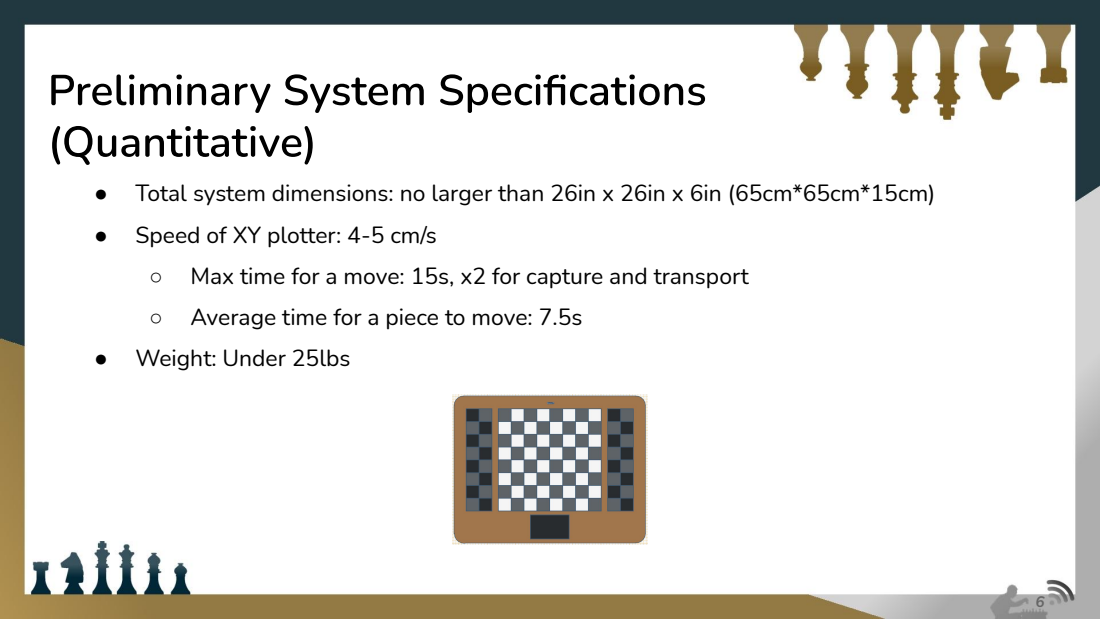
[picture p66: page 6]

● Total system dimensions: no larger than 26in x 26in x 6in (65cm*65cm*15cm)
● Speed of XY plotter: 4-5 cm/s
○ Max time for a move: 15s, x2 for capture and transport
○ Average time for a piece to move: 7.5s
● Weight: Under 25lbs

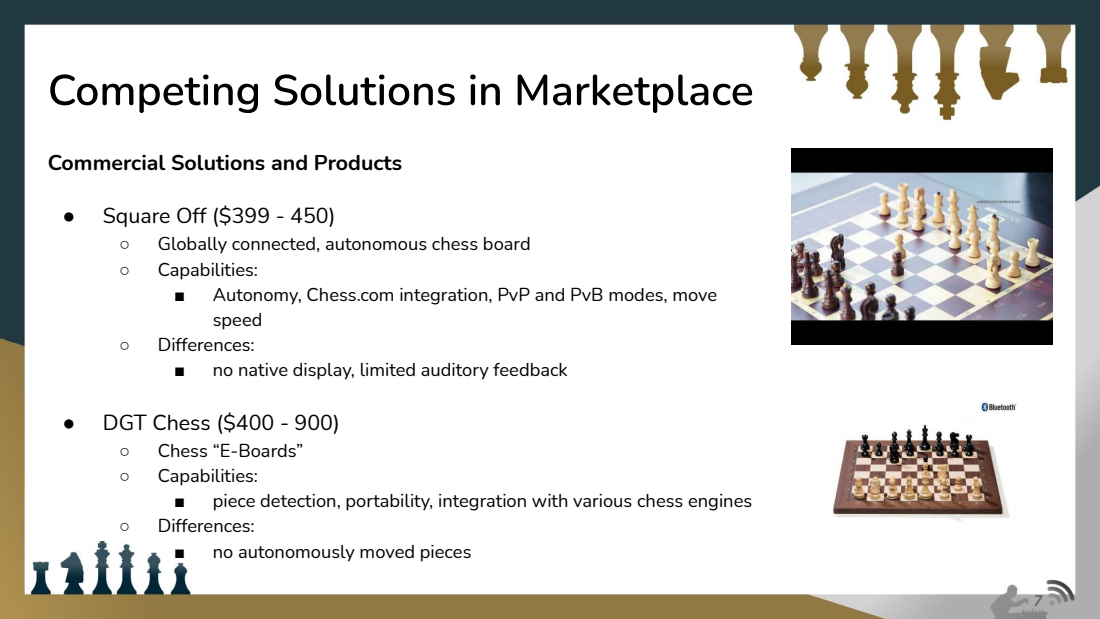
[picture p67: page 7]
Autonomy, Chess.com integration, PvP and PvB modes, move; ○ Differences:; no native display, limited auditory feedback; ● DGT Chess ($400 - 900) ○ Chess “E-Boards” ○ Capabilities:; piece detection, portability, integration with various chess engines; no autonomously moved pieces

Commercial Solutions and Products

● Square Off ($399 - 450)
○ Globally connected, autonomous chess board
○ Capabilities:
speed

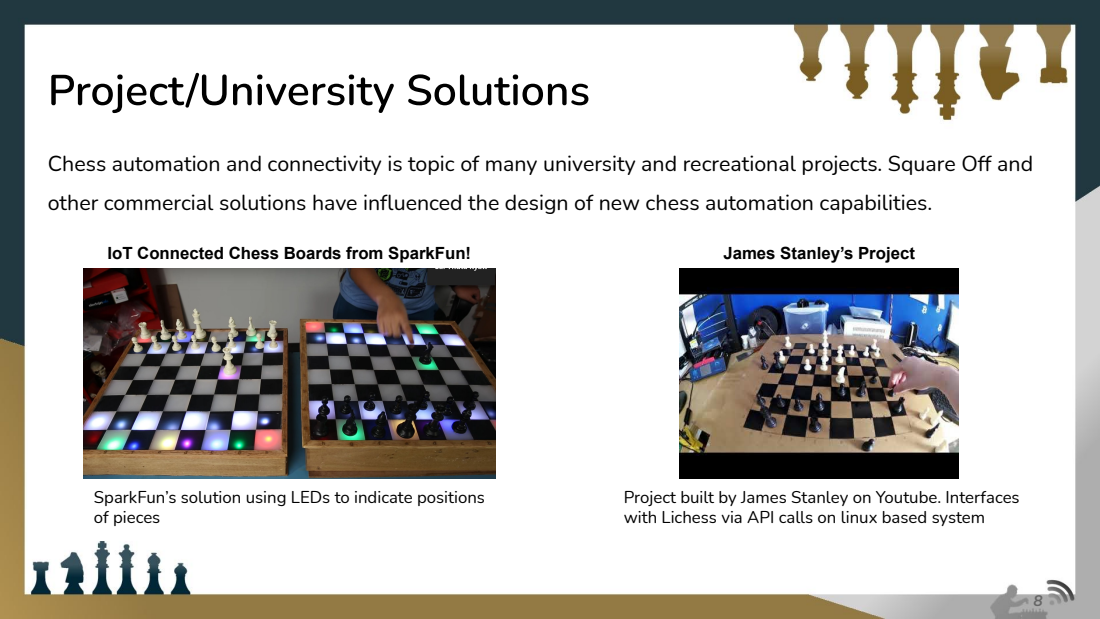
[picture p68: page 8]

Chess automation and connectivity is topic of many university and recreational projects. Square Off and
other commercial solutions have influenced the design of new chess automation capabilities.

IoT Connected Chess Boards from SparkFun!

James Stanley’s Project

SparkFun’s solution using LEDs to indicate positions
of pieces

Project built by James Stanley on Youtube. Interfaces
with Lichess via API calls on linux based system

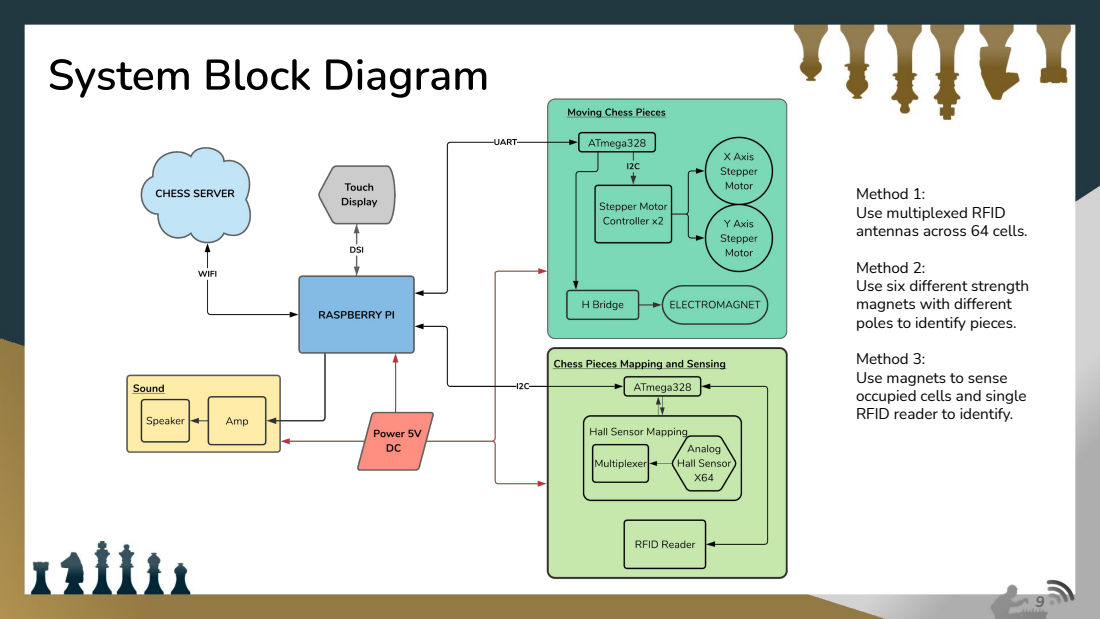
[picture p69: page 9]

Method 1:
Use multiplexed RFID
antennas across 64 cells.
Method 2:
Use six different strength
magnets with different
poles to identify pieces.
Method 3:
Use magnets to sense
occupied cells and single
RFID reader to identify.

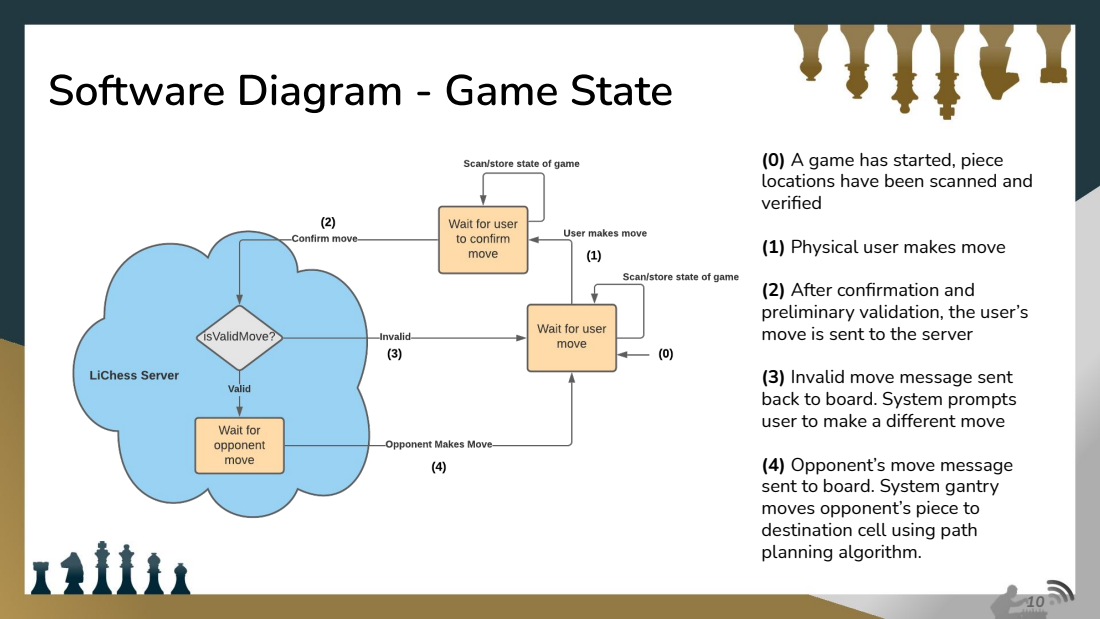
[picture p70: page 10]

(0) A game has started, piece
locations have been scanned and
verified
(1) Physical user makes move
(2) After confirmation and
preliminary validation, the user’s
move is sent to the server
(3) Invalid move message sent
back to board. System prompts
user to make a different move
(4) Opponent’s move message
sent to board. System gantry
moves opponent’s piece to
destination cell using path
planning algorithm.

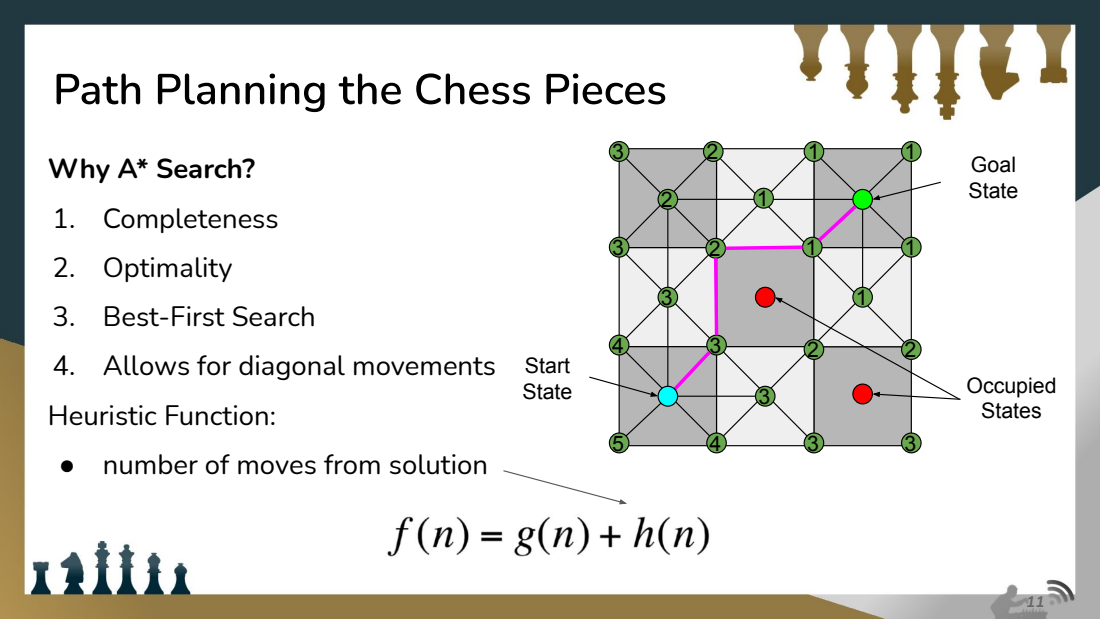
[picture p71: page 11]
Goal State; Start; State; Occupied; States

Why A* Search?
1. Completeness
2. Optimality
3. Best-First Search
4. Allows for diagonal movements
Heuristic Function: ● number of moves from solution

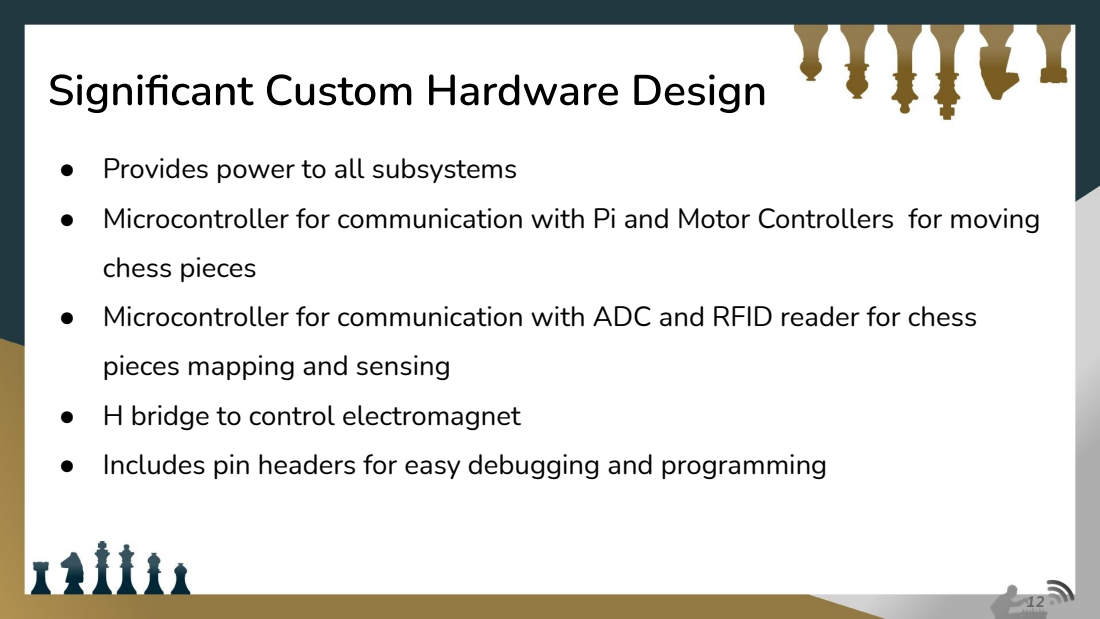
[picture p72: page 12]

● Provides power to all subsystems
● Microcontroller for communication with Pi and Motor Controllers for moving
chess pieces
● Microcontroller for communication with ADC and RFID reader for chess
pieces mapping and sensing
● H bridge to control electromagnet
● Includes pin headers for easy debugging and programming

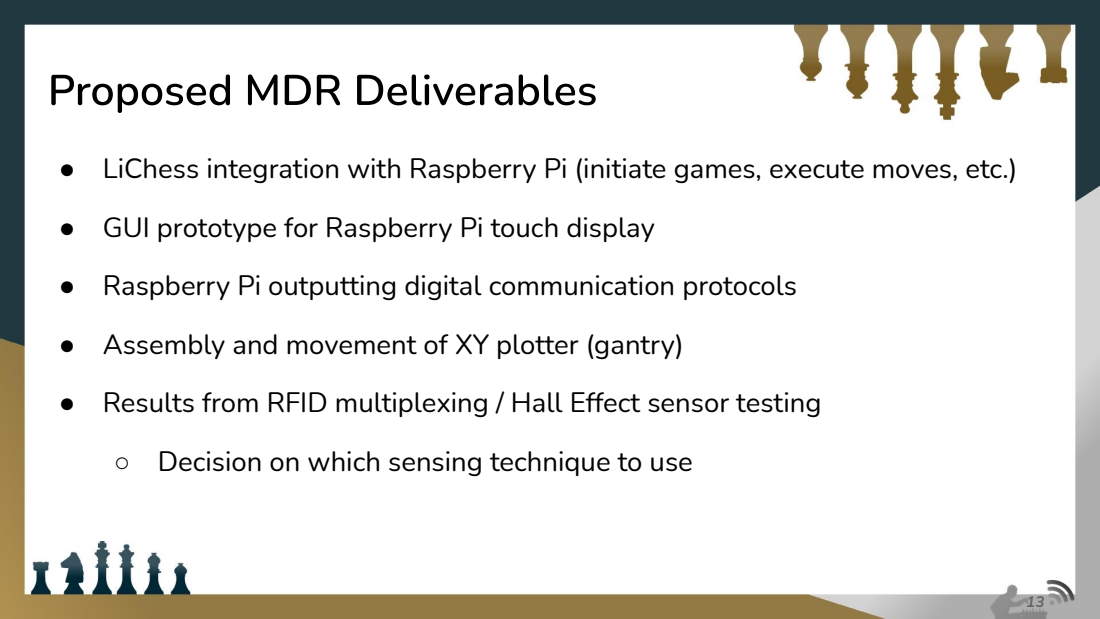
[picture p73: page 13]

● LiChess integration with Raspberry Pi (initiate games, execute moves, etc.)
● GUI prototype for Raspberry Pi touch display
● Raspberry Pi outputting digital communication protocols
● Assembly and movement of XY plotter (gantry)
● Results from RFID multiplexing / Hall Effect sensor testing
○ Decision on which sensing technique to use

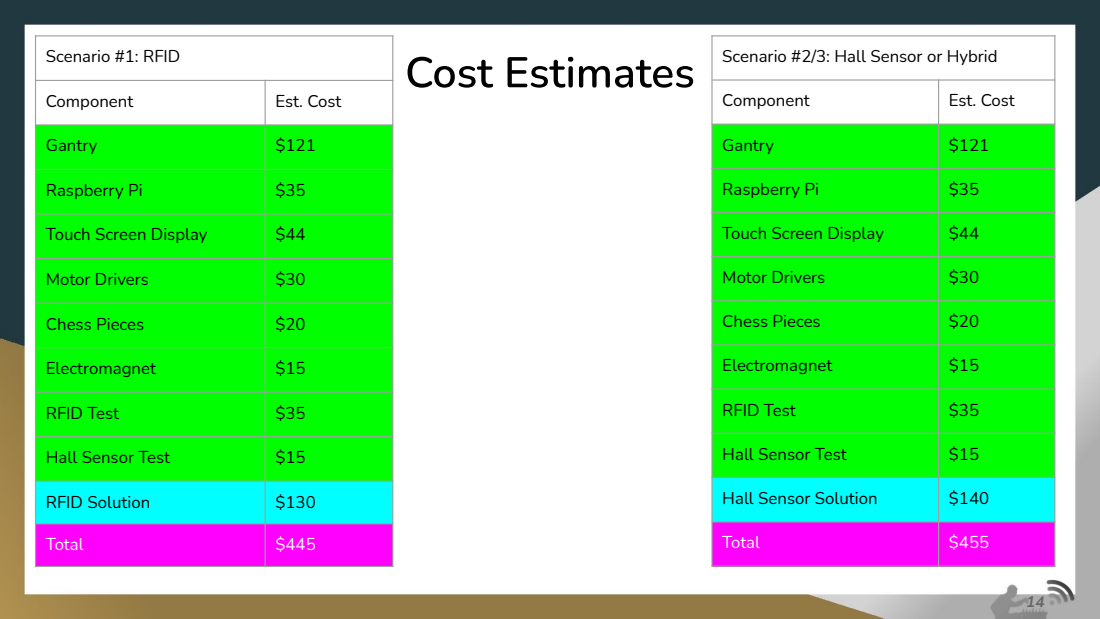
[picture p74: page 14]
Scenario #1: RFID; Component; Est. Cost; Gantry; Raspberry Pi; Touch Screen Display; Motor Drivers; Chess Pieces; Electromagnet; RFID Test; Total

Scenario #2/3: Hall Sensor or Hybrid

Hall Sensor Test | $15

RFID Solution | $130

Hall Sensor Solution | $140

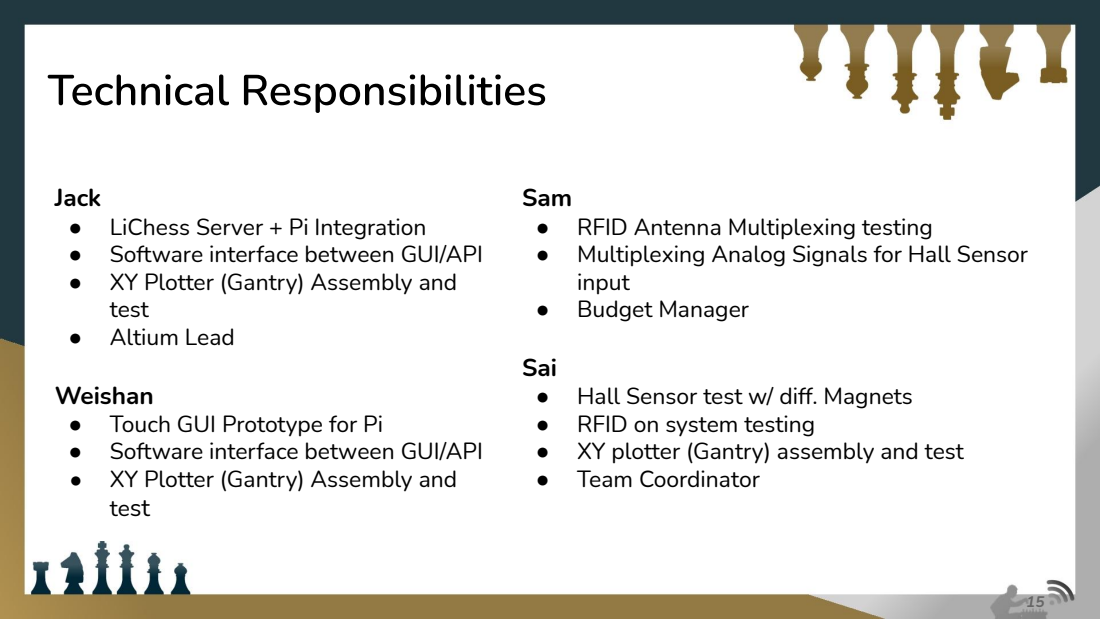
[picture p75: page 15]

Jack
● LiChess Server + Pi Integration
● Software interface between GUI/API
● XY Plotter (Gantry) Assembly and
test
● Altium Lead
Weishan
● Touch GUI Prototype for Pi

Sam
● RFID Antenna Multiplexing testing
● Multiplexing Analog Signals for Hall Sensor
input
● Budget Manager
Sai
● Hall Sensor test w/ diff. Magnets
● RFID on system testing
● XY plotter (Gantry) assembly and test
● Team Coordinator

16

Gantt Chart

Overarching category | Task | Team Member | Sept 21 -Sept 25 | Sept 28 -Oct 2 | Oct 5 -Oct 9 | Oct 12 -Oct 16 | Oct 19 -Oct 23 | Oct 26 -Oct 30 | Nov 2 -Nov 6 | Nov 9 -Nov 13
Network/Server Interface | Lichess server + Raspberry Pi integration | Jack
Display/Touch Interface | Touch GUI design and prototype for RPi display | Wei
Network/Server Interface | Software interface between GUI and API | Jack,Wei
Communication Protocol | Communication with RPi SPI, UART, I2C | Jack,Wei
Path Planning | Path Planning Algorithm | Jack,Wei
Sensing | RFID antenna multiplexing | Sam
Sensing | Multiplexing Analog Signals for Hall Sensor input | Sam
Sensing | Hall Sensor Test with Chess piece | Sai
Sensing | RFID system test | Sai
Gantry + Moving | Moving Gantry XY axis Assembly and test | Jack, Wei, Sai
Moving | Electromagnet switch working | Jack, Wei, Sai

17

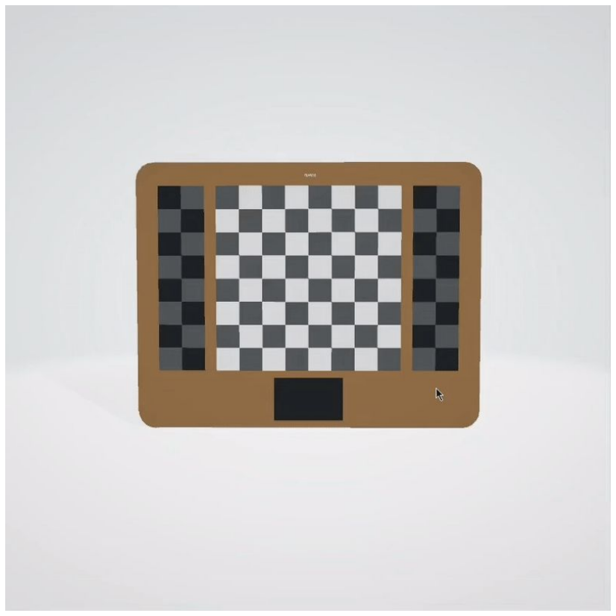
[picture p76: figure]
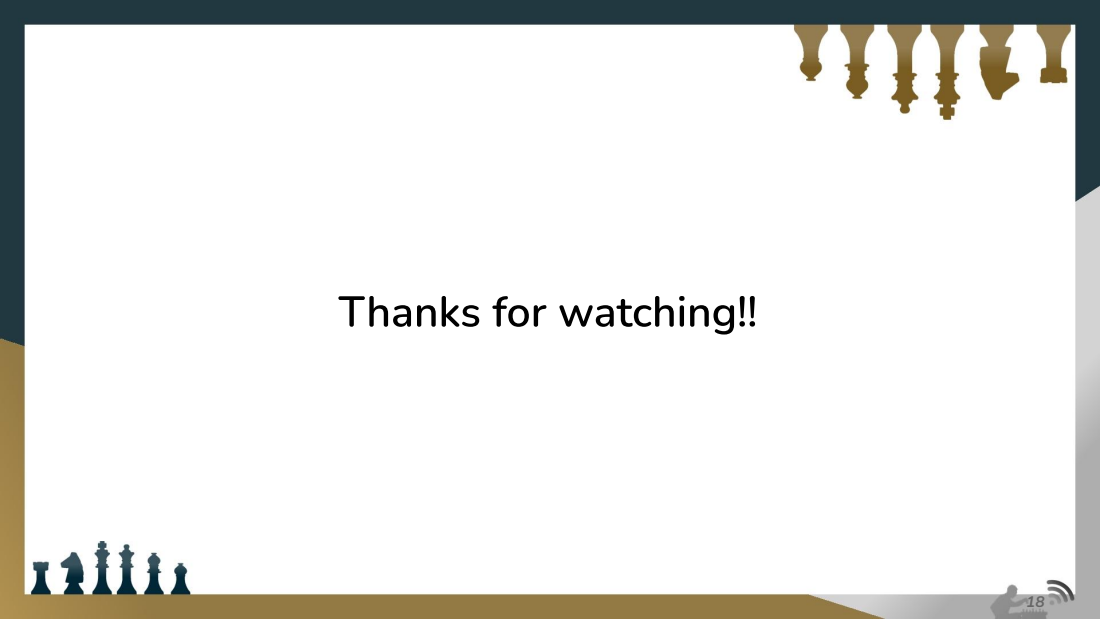
[picture p77: page 18]

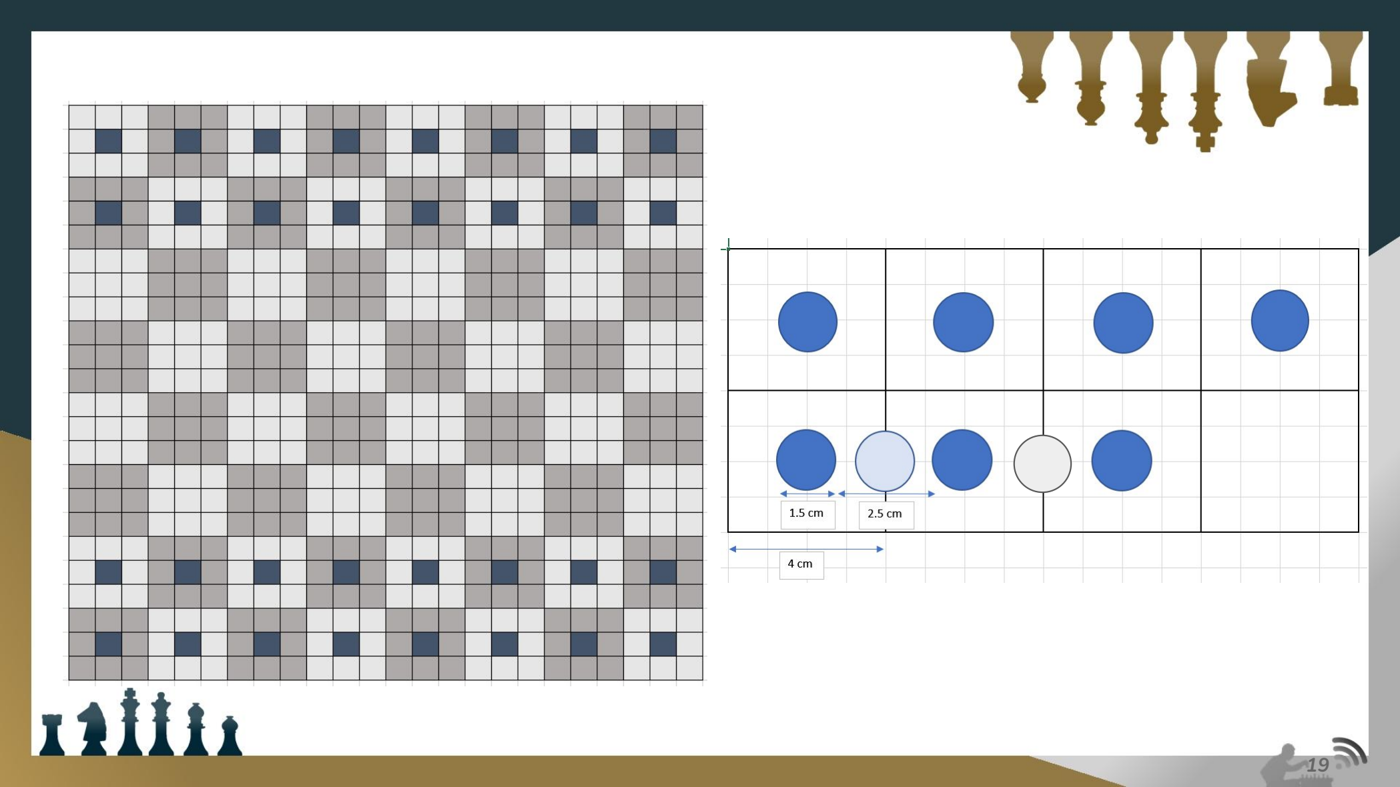
[picture p78: page 19]

19
