degugj/lichessTesting/(commit log)

2020-10-08 swap frames/pages, main menu
2020-10-16 modified gameState.py, draw chessboard/pieces
    [config.txt]
2020-10-23 Implemented move function for local gamestate. Fixed orientation of the board (Row 1 is white)
2020-10-26 terminating working properly? clean up files
    [config.txt]
2020-11-03 Fixes to print position map. Implemented a successful heuristic (using straight line distance). Now we can implement astar for game board pathplanning.
2020-11-13 New dir for Sam and Sai's arduino code
2020-11-14 Add files via upload
    Final code for Hall Effect Sensor with Mux. (I know the title says demux, but I used a mux)
2020-11-14 Add files via upload
    Final code for controlling an LED with a hall effect sensor.
2020-11-16 Add files via upload
    Final MDR code for controlling an LED with the RC522.
2020-12-09 Updates to position map (removed leftmost and rightmost columns). Time to work on supporting the UART protocol.
2020-12-09 Skeleton code for path transmission using custom UART protocol
2020-12-10 Message encodings for UART protocol complete. I have to implement them with a full path. Then I can work on using the pi to see if we can transmit this info to 328p.
2020-12-10 Encodings for transmitting UART messages to 328.
2021-01-03 Tested with gantry. Making updates to 328 interface messages.
2021-01-04 Updates and skeletal code for receiving ACKs from 328p. Will test with Sai's gantry simulator ASAP. Warning: code is currently untested
2021-01-05 Updates to UART receive functionality. Added some delays that need testing. Need to add messages and error catching/tolerance
2021-01-12 gantry testing boolean
2021-01-12 Modifying files to work with Pi and gantry test
2021-01-12 fixed castling for gantry
2021-01-12 fixed castling for gantry v2
2021-01-20 Fixed position map piece capture. Finds appropriate position based on piece captured.
    [x328p_interface.py]
2021-01-20 Removed long sys out prints for testing and video.
2021-01-20 Fixes to buffer zone position resolution.
    [x328p_interface.py]
2021-01-20 Updates to diagnose errors with UART.
    [x328p_interface.py]
2021-01-23 buttons for resign/abort... wip
2021-01-25 resignation button working
2021-01-26 abort button working
2021-02-19 Updates and working simulator for Sam's testing. Transmits start command and prints returned byte.
2021-02-19 Arduino simulator
2021-03-07 I2C code for the 328p
    Added new folder and the first few c files
2021-03-07 Adding new I2C files
2021-03-07 I2C files
2021-03-09 changed device to Atmega328
2021-03-10 experimenting to send i2c data
2021-03-11 tried new i2c code
2021-03-17 Quick edits for Sam to print a byte to the Pi
2021-03-18 Preparing to change gears from i2c to UART
2021-03-18 created new folder and code for hall sensor UART
2021-03-19 Setup test environment and dummy messages for mocking fs interface. Jack will proceed with UART support (generate message object). Wei wants to help design methods.
2021-03-20 Finished gamestate comparison with Wei. He is going to work on resolving move. I will work on working with UART for Sam.
2021-03-20 Removed prints
2021-03-20 error messages, abort button removal
2021-03-21 gui raspberry pi ready
2021-03-23 implemented resolve_chess_move for non-capturing non-castling
    [x328p_fs_interface.py]
2021-03-23 Fixed SetABC (i think!)
    [main.c]
2021-03-24 working on hall sensor indexing
2021-03-27 Printing both bytes for Sam.
2021-03-27 Adding start FS UART message transmission.
2021-03-27 Printing the move sent by Sam.
2021-03-27 Adding print statement for resolve move bug.
    [x328p_fs_interface.py]
2021-03-27 more testing of hall sensor locations and sending data to Pi
2021-03-29 More robust print statements for FS messaging and CDR demo.
2021-03-29 Fix id to return string field.
    [x328p_fs_interface.py]
2021-03-29 Fix spacing on print statements.
    [x328p_fs_interface.py]
2021-03-29 Adding chess cell column to print statement.
2021-03-31 Switching to big endian for Sam's demo
2021-03-31 Hotfix for flipping data byte from Sam.
    [x328p_fs_interface.py]
2021-03-31 Support for busy gantry message.
2021-03-31 Fixing code to continue without exiting for Wei gui.
    [x328p_gantry_interface.py]
2021-04-01 Removing D from hall sensor demo
2021-04-01 Removing some redundant prints
2021-04-11 can successfully perform multiple moves without reset
    [main.c]
2021-04-11 Cleaning up gantry interface code
2021-04-12 Switching to a3
2021-04-13 Cleaning gantry code and major untested updates to move resolution.
2021-04-13 Adding prints for debugging
2021-04-13 printing gamestate
2021-04-14 Need None case for game queue or else I can't test without GUI
2021-04-15 boolean for gantry movement
2021-04-17 Transmit uart loop for integration testing.
2021-04-17 Prints for figuring out move resolution
2021-04-17 Fixing more indexing for move resolution.
    [x328p_fs_interface.py]
2021-04-17 printing info on indexing issue
    [x328p_fs_interface.py]
2021-04-17 Prints for column comparison
2021-04-17 Prints for more column analysis. Might add for loop after
2021-04-17 Strange index issue. Testing plus one update
    [x328p_fs_interface.py]
2021-04-17 Removing prints for demo
2021-04-17 Editing more prints to demo moves
2021-04-17 Removing redundant prints in comparison.
2021-04-17 Bug in resolving capturing start cell
    [x328p_fs_interface.py]
2021-04-17 Quick fix for testing indexing bug
    [x328p_fs_interface.py]
2021-04-17 Printing start cell
2021-04-20 Transmit and read spi test
2021-04-21 Updates to receive SPI transmission.
2021-04-21 New spi code for FS interface
2021-04-21 Changes to support SPI FS
2021-04-21 Updating test file for testing SPI FS updates.
2021-04-21 Changes to support SPI
2021-04-21 Adding prints for testing Gamestate.
2021-04-21 Mirroring Data bits for SPI
2021-04-21 Working Checkpoint for SPI Fast Scanning. Just adding gamestate updates for after resolving move.
2021-04-21 Swapping buffer zones for demo. And updating gantry test.
2021-04-21 Fixing buffer position and reverting gamestate.
    [x328p_gantry_interface.py]
2021-04-21 Fixes to swapping buffer zones are complete and tested
    [x328p_gantry_interface.py]
2021-04-21 New FS on Raspberry Pi
2021-04-22 Bug fixes on indexing position map
    [x328p_gantry_interface.py]
2021-04-22 print to check index out of range
2021-04-22 Test state and seem to have solved the buffer index bug
    [x328p_gantry_interface.py]
2021-04-27 Updated initial test state and reverting back to appropriate buffer zone locations.
    [x328p_gantry_interface.py]
2021-04-28 Adding Print for Gamestate
2021-04-29 Reset game state has been implemented. Ready for system testing
    [x328p_gantry_interface.py]
2021-04-29 Test case as well as bug fixes with the reset gamestate
    [x328p_gantry_interface.py]
2021-04-30 Turn on EM confirm UART Message
2021-04-30 Adding topple king function for gantry
2021-04-30 remove bottom row gantry
2021-04-30 Removing top and bottom rows to protect physical limits of gantry
2021-04-30 Print and edit in topple king
2021-04-30 Quick fix for king position
    [x328p_gantry_interface.py]
2021-04-30 Updates to fix errors
    [x328p_gantry_interface.py]
2021-05-14 Delete 328p I2C directory
    Cleanup for Archival
2021-05-14 Delete I2C directory
    Cleanup
2021-05-17 Added Gantry control
2025-04-13 Hotfix for skipping arrival when receiving XADDRESS.
    Patch for Philip at M5 to handle case Raspberry Pi missing ARRIVAL message after GO command.
    [x328p_gantry_interface.py]
